pacabot/zhonx3-kicad/Zhonx_III_bt/gerber/Zhonx_III-F_Cu.dxf

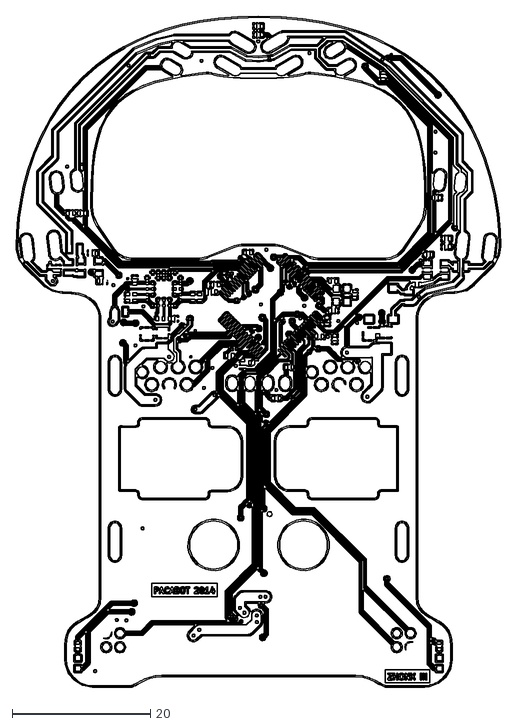
[picture p1: CAD file, 2015-01-23]
Zhonx_III_bt/gerber/Zhonx_III-F_Cu.dxf
70.0 x 97.0
