pacabot/zhonx3-kicad/Zhonx_III_mere_V3/Gerber/Zhonx_III-Edge_Cuts.dxf

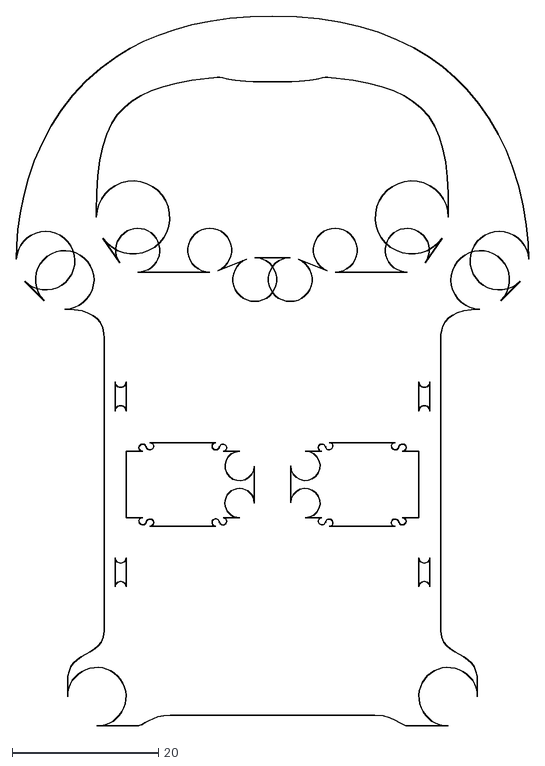
[picture p2: CAD file, 2015-01-23]
Zhonx_III_mere_V3/Gerber/Zhonx_III-Edge_Cuts.dxf
70.0 x 97.0
