pacabot/zhonx3-kicad/Zhonx_III_bt/gerber/ContourPCBrepris.dxf

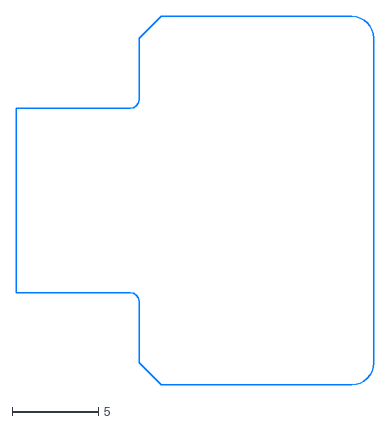
[picture p3: CAD file, 2015-01-23]
Zhonx_III_bt/gerber/ContourPCBrepris.dxf
20.7 x 21.3
