pacabot/zhonx3-kicad/Zhonx_III_bt/gerber/Zhonx_III-Edge_Cuts.dxf

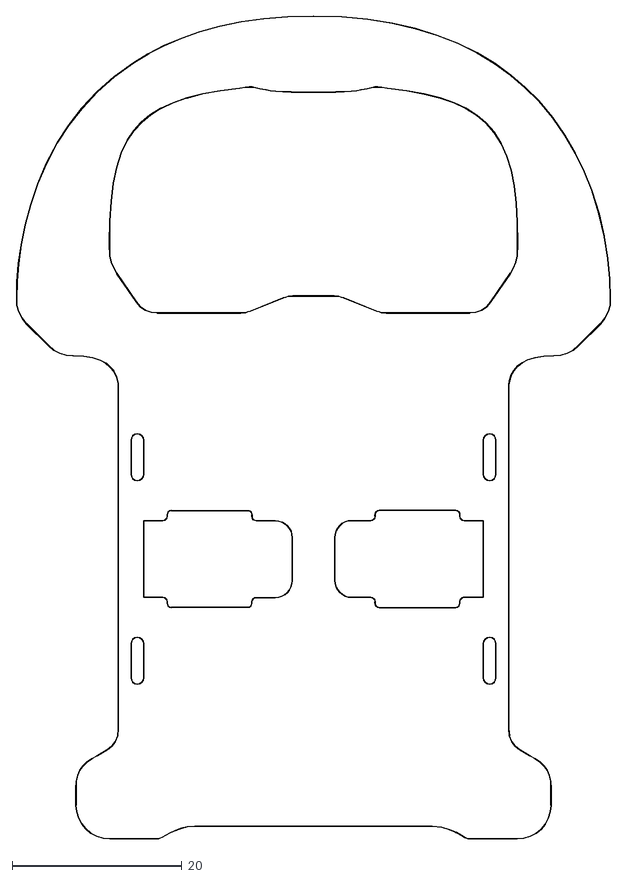
[picture p4: CAD file, 2015-01-23]
Zhonx_III_bt/gerber/Zhonx_III-Edge_Cuts.dxf
70.1 x 97.0
