pacabot/zhonx3-kicad/Zhonx_III_bt/gerber/Zhonx_III-B_Cu.dxf

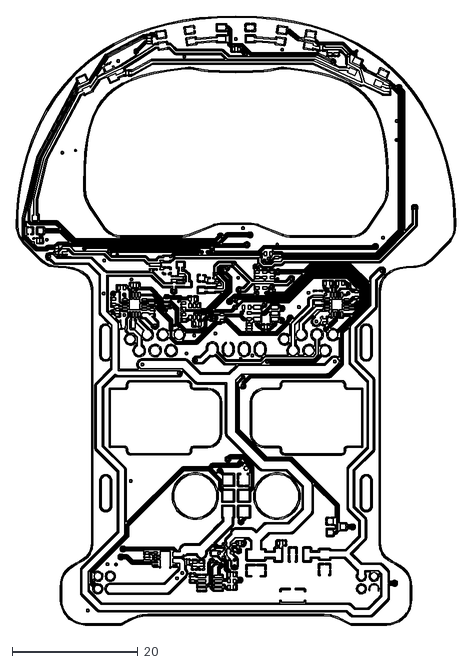
[picture p5: CAD file, 2015-01-23]
Zhonx_III_bt/gerber/Zhonx_III-B_Cu.dxf
70.0 x 97.0
