pacabot/zhonx3-kicad/Zhonx_III_bt/gerber/Zhonx3_carteBT-Edge_CutsV0.dxf

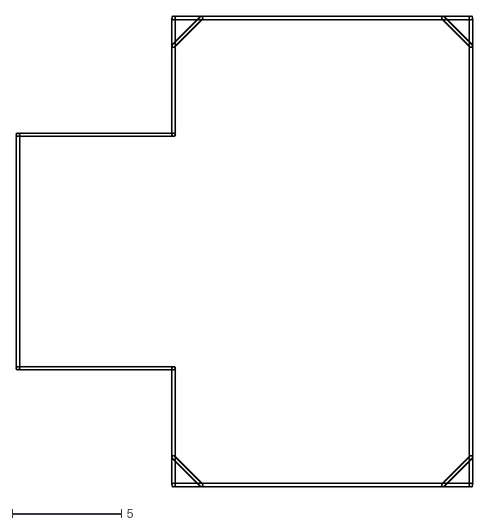
[picture p6: CAD file, 2015-01-23]
Zhonx_III_bt/gerber/Zhonx3_carteBT-Edge_CutsV0.dxf
20.9 x 21.5
