pacabot/zhonx3-kicad/Zhonx_III_bt/gerber/ContourPCBreprisV2.dxf

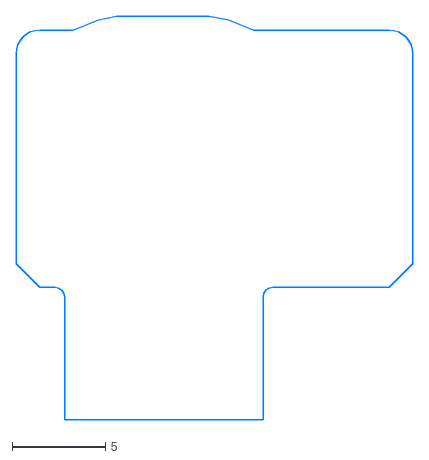
[picture p7: CAD file, 2015-01-23]
Zhonx_III_bt/gerber/ContourPCBreprisV2.dxf
21.3 x 21.7
