pacabot/zhonx3-kicad/Zhonx_III_base_V2/Gerber/Zhonx_III_Base-Edge_Cuts.dxf

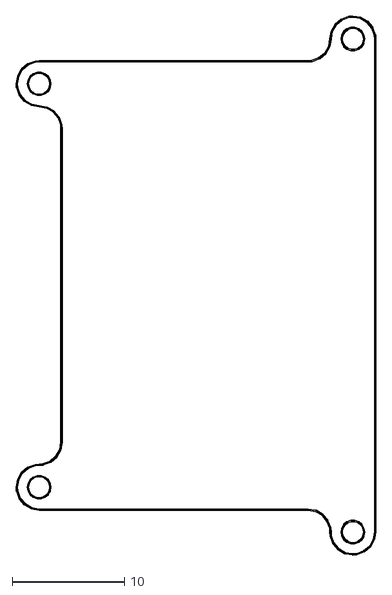
[picture p8: CAD file, 2015-05-01, an earlier design]
Zhonx_III_base_V2/Gerber/Zhonx_III_Base-Edge_Cuts.dxf
32.1 x 48.1
