pacabot/zhonx3-kicad/Zhonx_III_base_V2/Gerber/Zhonx_III_Base-F_Cu.dxf

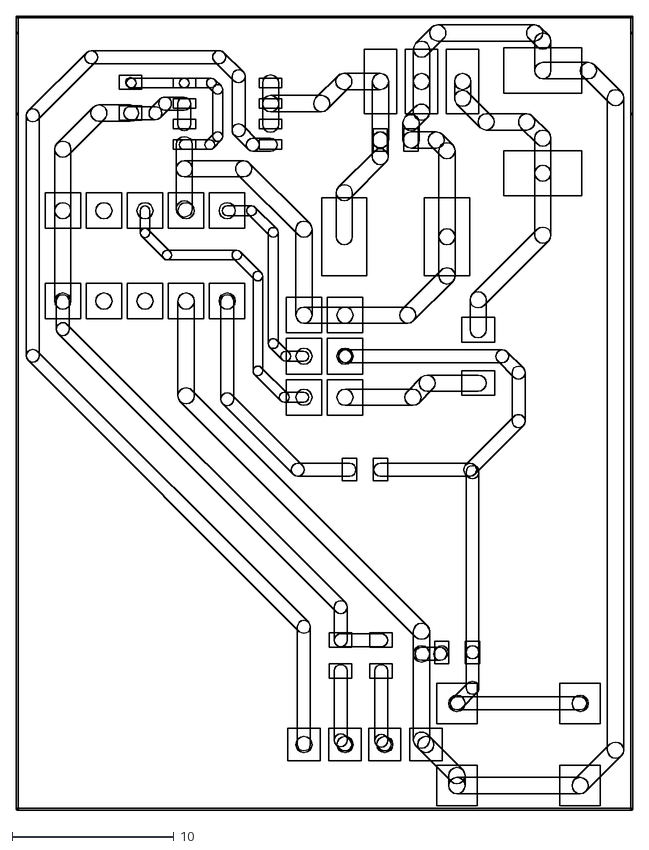
[picture p9: CAD file, 2015-01-23, an earlier design]
Zhonx_III_base_V2/Gerber/Zhonx_III_Base-F_Cu.dxf
38.1 x 49.1
