pacabot/zhonx3-kicad/(list of files, cad)

Other CAD files:
Zhonx_III_base_V2/CamBam/Zhonx_III_Base-Edge_Cuts_decompose.dxf
Zhonx_III_base_V2/CamBam/Zhonx_III_Base-Edge_Cuts.dxf
Zhonx_III_bt/gerber/Zhonx_III-F_SilkS.dxf
Zhonx_III_mere_V3/Gerber/Zhonx_III-B_Mask.dxf
Zhonx_III_mere_V3/Gerber/Zhonx_III-F_Mask.dxf
