pacabot/zhonx3-kicad/Zhonx_III_mere_V3/Zhonx_III.pdf

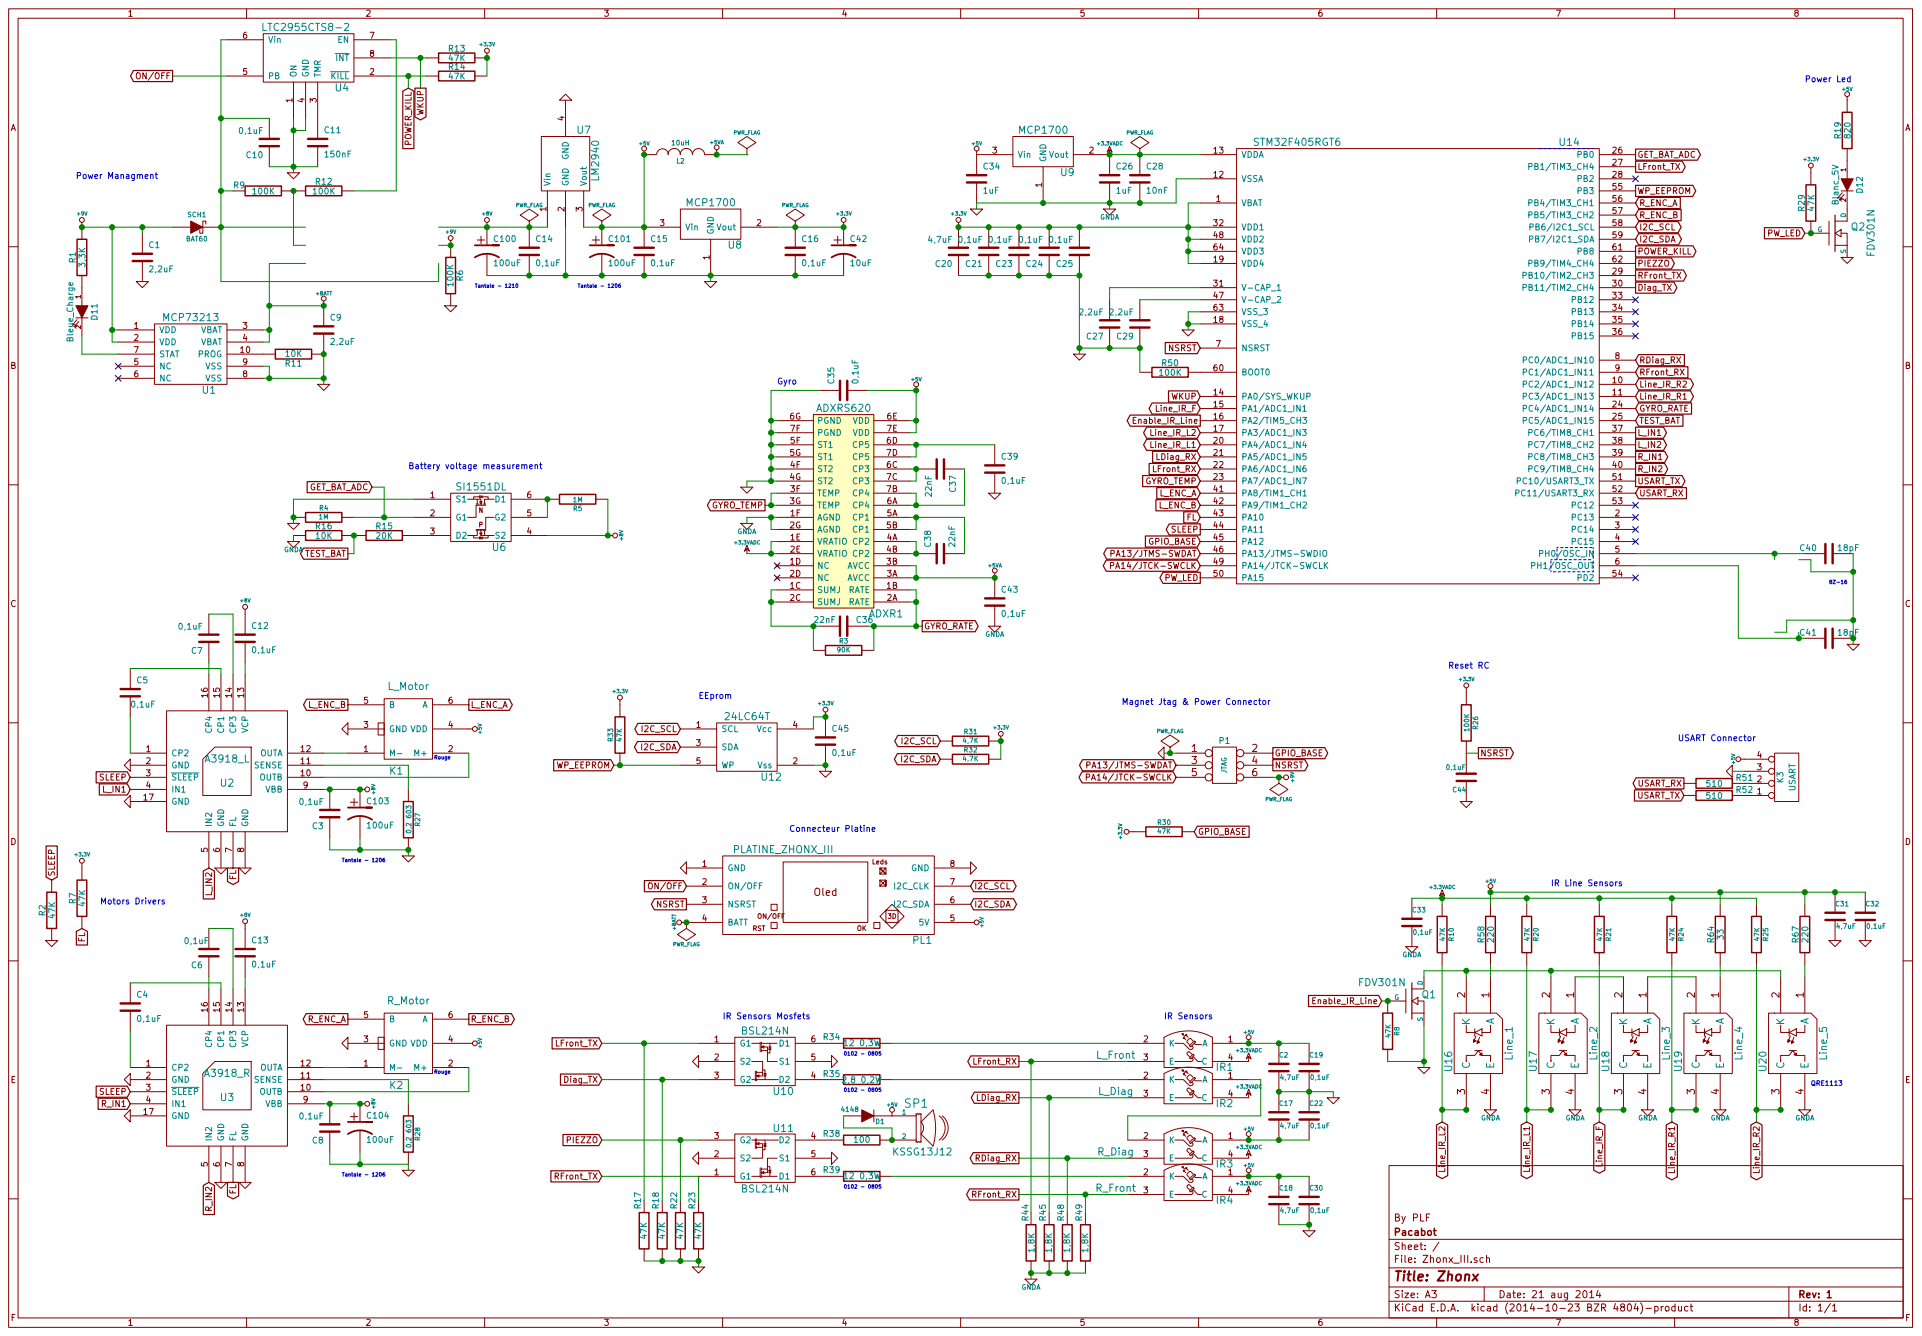
[picture p11: page 1]

PA13/JTMS-SWDAT PA14/JTCK-SWCLK

8 VBB 9 OUTB 10 SENSE 11 OUTA 12 VCP 13 CP3 14 CP1 15 CP4 16 GND 17 U2 A3918_L R27 0,2 603

8 VBB 9 OUTB 10 SENSE 11 OUTA 12 VCP 13 CP3 14 CP1 15 CP4 16 GND 17 U3 A3918_R R_IN2FL
