pacabot/zhonx3-kicad/Zhonx_III_bt/gerber/Zhonx3_carteBT.pdf

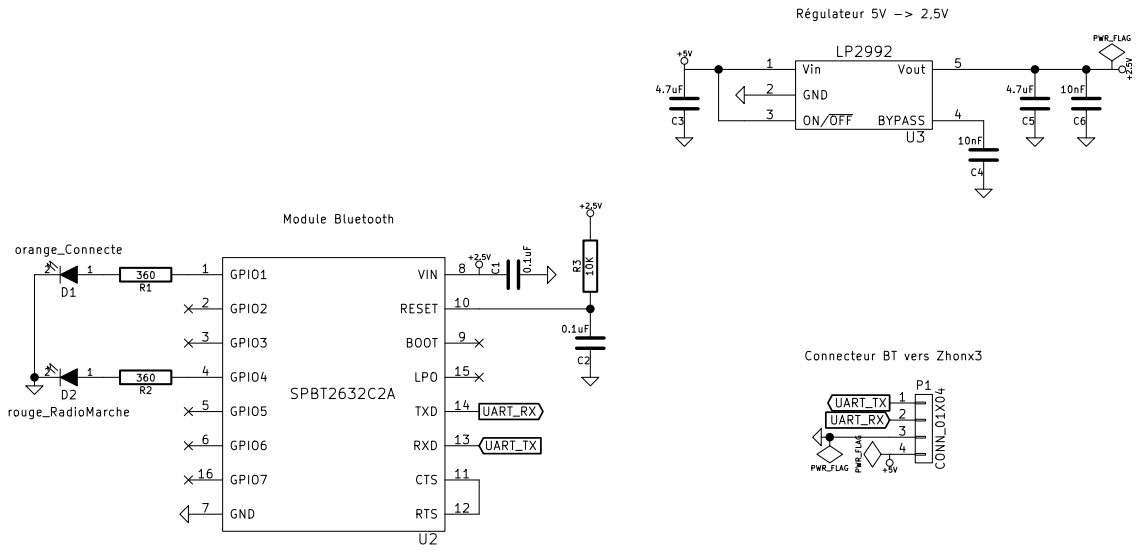
[picture p12: page 1]

10nF Connecteur BT vers Zhonx3 Régulateur 5V -> 2,5V Module Bluetooth
