pacabot/zhonx3-kicad/Zhonx_III_bt/gerber/Zhonx3_carteBT-B_Cu.pdf

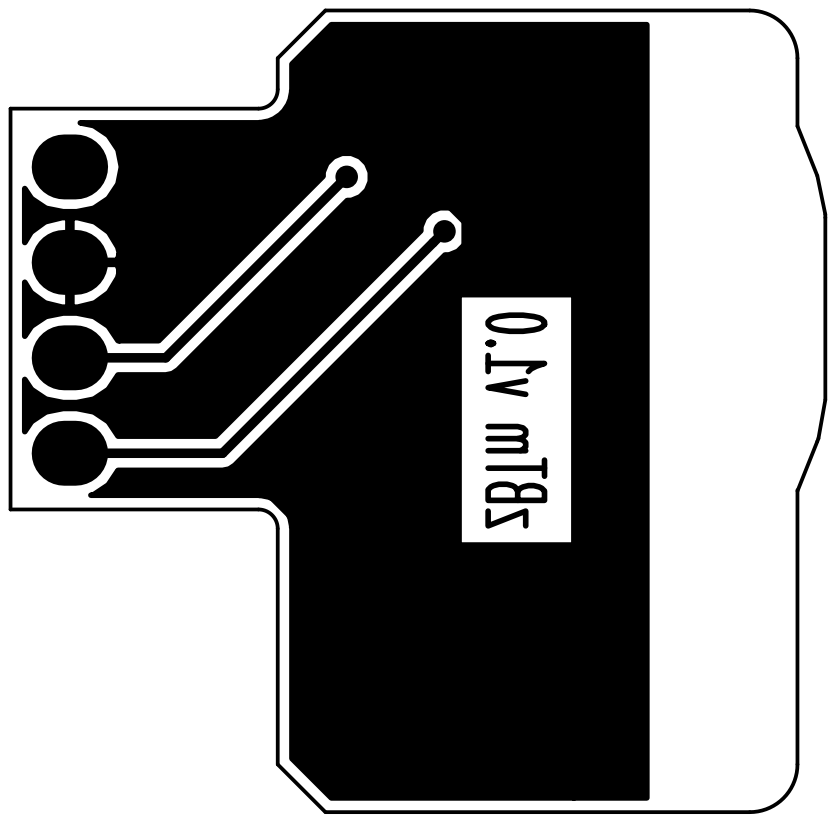
[picture p13: page 1]
