pacabot/zhonx3-kicad/Zhonx_III_bt/gerber/Zhonx3_carteBT-Edge_Cuts.pdf

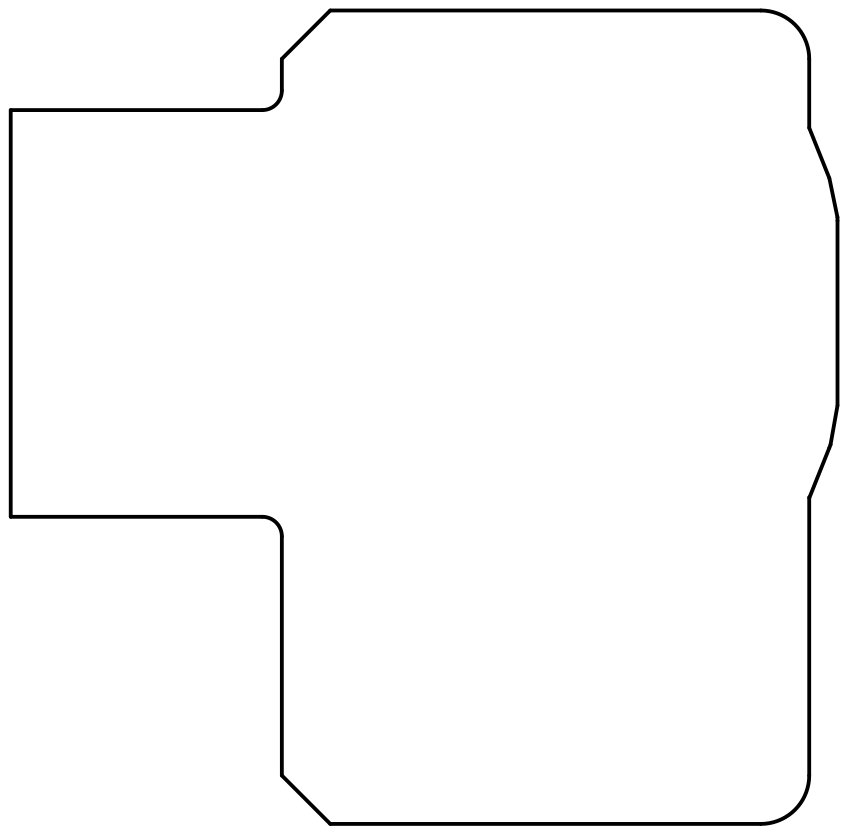
[picture p14: page 1]
