pacabot/zhonx3-kicad/Zhonx_III_bt/gerber/Zhonx3_carteBT-F_Cu.pdf

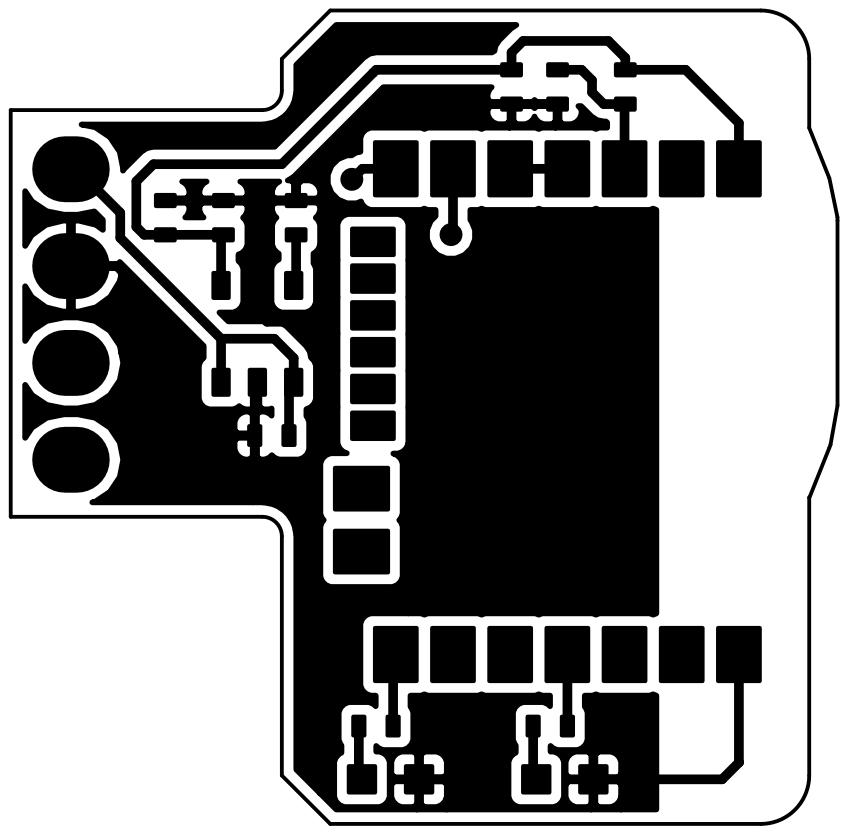
[picture p15: page 1]
