pacabot/zhonx3-kicad/Zhonx_III_bt/gerber/Zhonx3_carteBT-F_SilkS.pdf

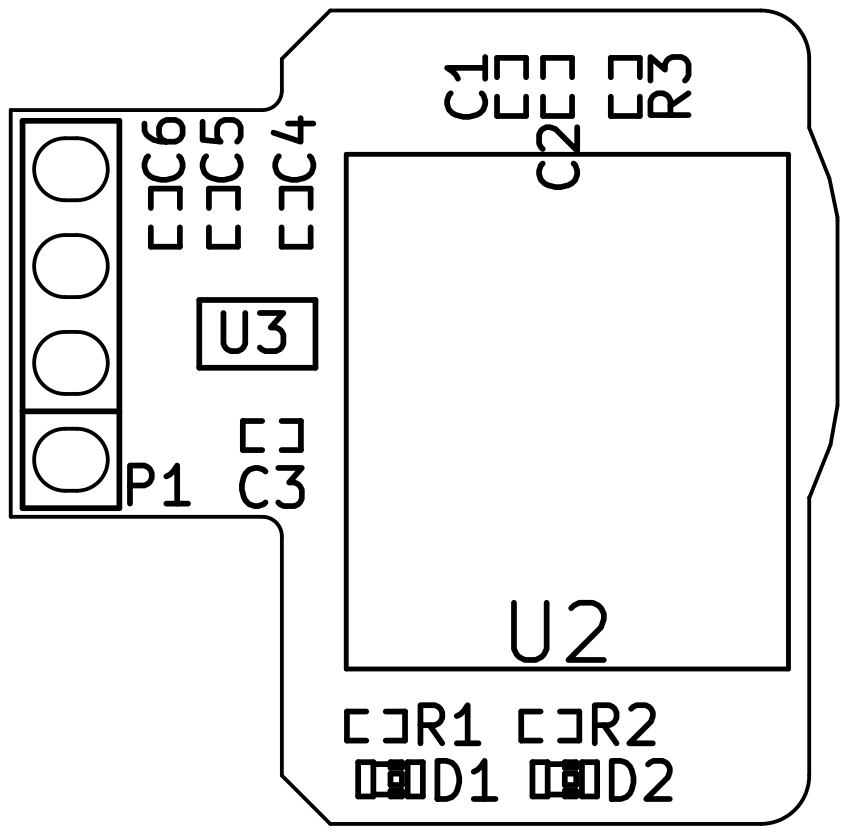
[picture p16: page 1]
