pacabot/zhonx3-kicad/Zhonx_III_mere_V3/Zhonx_III.cir

* EESchema Netlist Version 1.1 (Spice format) creation date: 07/05/2013 12:43:24

* To exclude a component from the Spice Netlist add [Spice_Netlist_Enabled] user FIELD set to: N
* To reorder the component spice node sequence add [Spice_Node_Sequence] user FIELD and define sequence: 2,1,0

*Sheet Name:/
R17  31 0 10K		
R18  30 0 10K		
R20  32 0 10K		
R21  29 0 10K		
R22  33 0 10K		
R23  28 0 10K		
U11  33 79 28 121 79 120 BSL214N		
U10  32 79 29 125 79 124 BSL214N		
R39  94 121 12 0,3W		
R34  25 122 12 0,3W		
U9  31 79 30 123 79 122 BSL214N		
SCH2  17 105 DIODESCH		
R14  141 67 10K		
C10  0 46 0,1uF		
R9  46 45 100K		
C11  119 0 150nF		
U4  0 141 119 0 65 46 27 153 LTC2955TS8-2		
R13  153 67 10K		
R12  45 27 100K		
SCH1  105 46 DIODESCH		
U5  45 64 105 46 46 55 IRF5810		
R35  123 24 5,6 0,2W		
R38  43 120 5,6 0,2W		
R37  125 43 5,6 0,2W		
R36  124 24 5,6 0,2W		
R49  26 0 1,8K		
R48  23 0 1,8K		
R1  130 105 ?		
D11  130 10 Bleue_Charge		
C30  93 0 4,7uF		
D9  127 35 Orange		
R32  127 93 820		
D8  36 126 Orange		
R31  36 93 820		
R24  111 93 820		
R25  5 93 820		
R26  112 93 820		
R27  38 93 820		
R28  129 93 820		
R29  4 93 820		
R58  128 93 82		
U6  39 138 3 103 40 0 110 34 126 35 81 104 96 67 78 106 0 MAX7317		
R6  0 105 100K		
C1  105 0 2,2uF		
C9  64 11 2,2uF		
R11  11 47 10K		
P1  20 18 48 77 19 17 51 11 JTAG		
U2  159 0 117 150 100 21 11 55 57 56 22 0 118 12 113 144 0 A3950_L		
C12  22 56 0,1uF		
R2  0 117 5K		
U1  105 105 64 64 101 99 10 11 11 47 MCP73213		
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
F1  64 75 FUSE		
C38  77 0 0,1uF		
R66  67 77 100K		
R62  61 95 12		
L1  67 108 10uH		
U15  66 79 60 62 79 61 BSL214N		
R57  66 0 10K		
R59  60 0 10K		
C2  0 65 0,1uF		
BT1  75 11 LYPO_2S		
D10  80 81 Vert		
R68  80 93 820		
U8  0 67 93 MCP1703		

.end
