pacabot/zhonx3-kicad/(list of files, drawings)

Other design files:
Zhonx_III_base_V2/Zhonx_III_Base.dsn
Zhonx_III_bt/Zhonx3_carteBT.dsn
Zhonx_III_mere_V3/Freerouter/Zhonx_III.dsn
Zhonx_III_mere_V3/Zhonx_III.dsn
Zhonx_III_platine/Zhonx_Platine.dsn
