pacabot/zhonx3-kicad/Zhonx_III_base_V2/Zhonx_III_Base.kicad_pcb

## KiCad design Zhonx_III_base_V2/Zhonx_III_Base.kicad_pcb (2015-05-01, an earlier design)

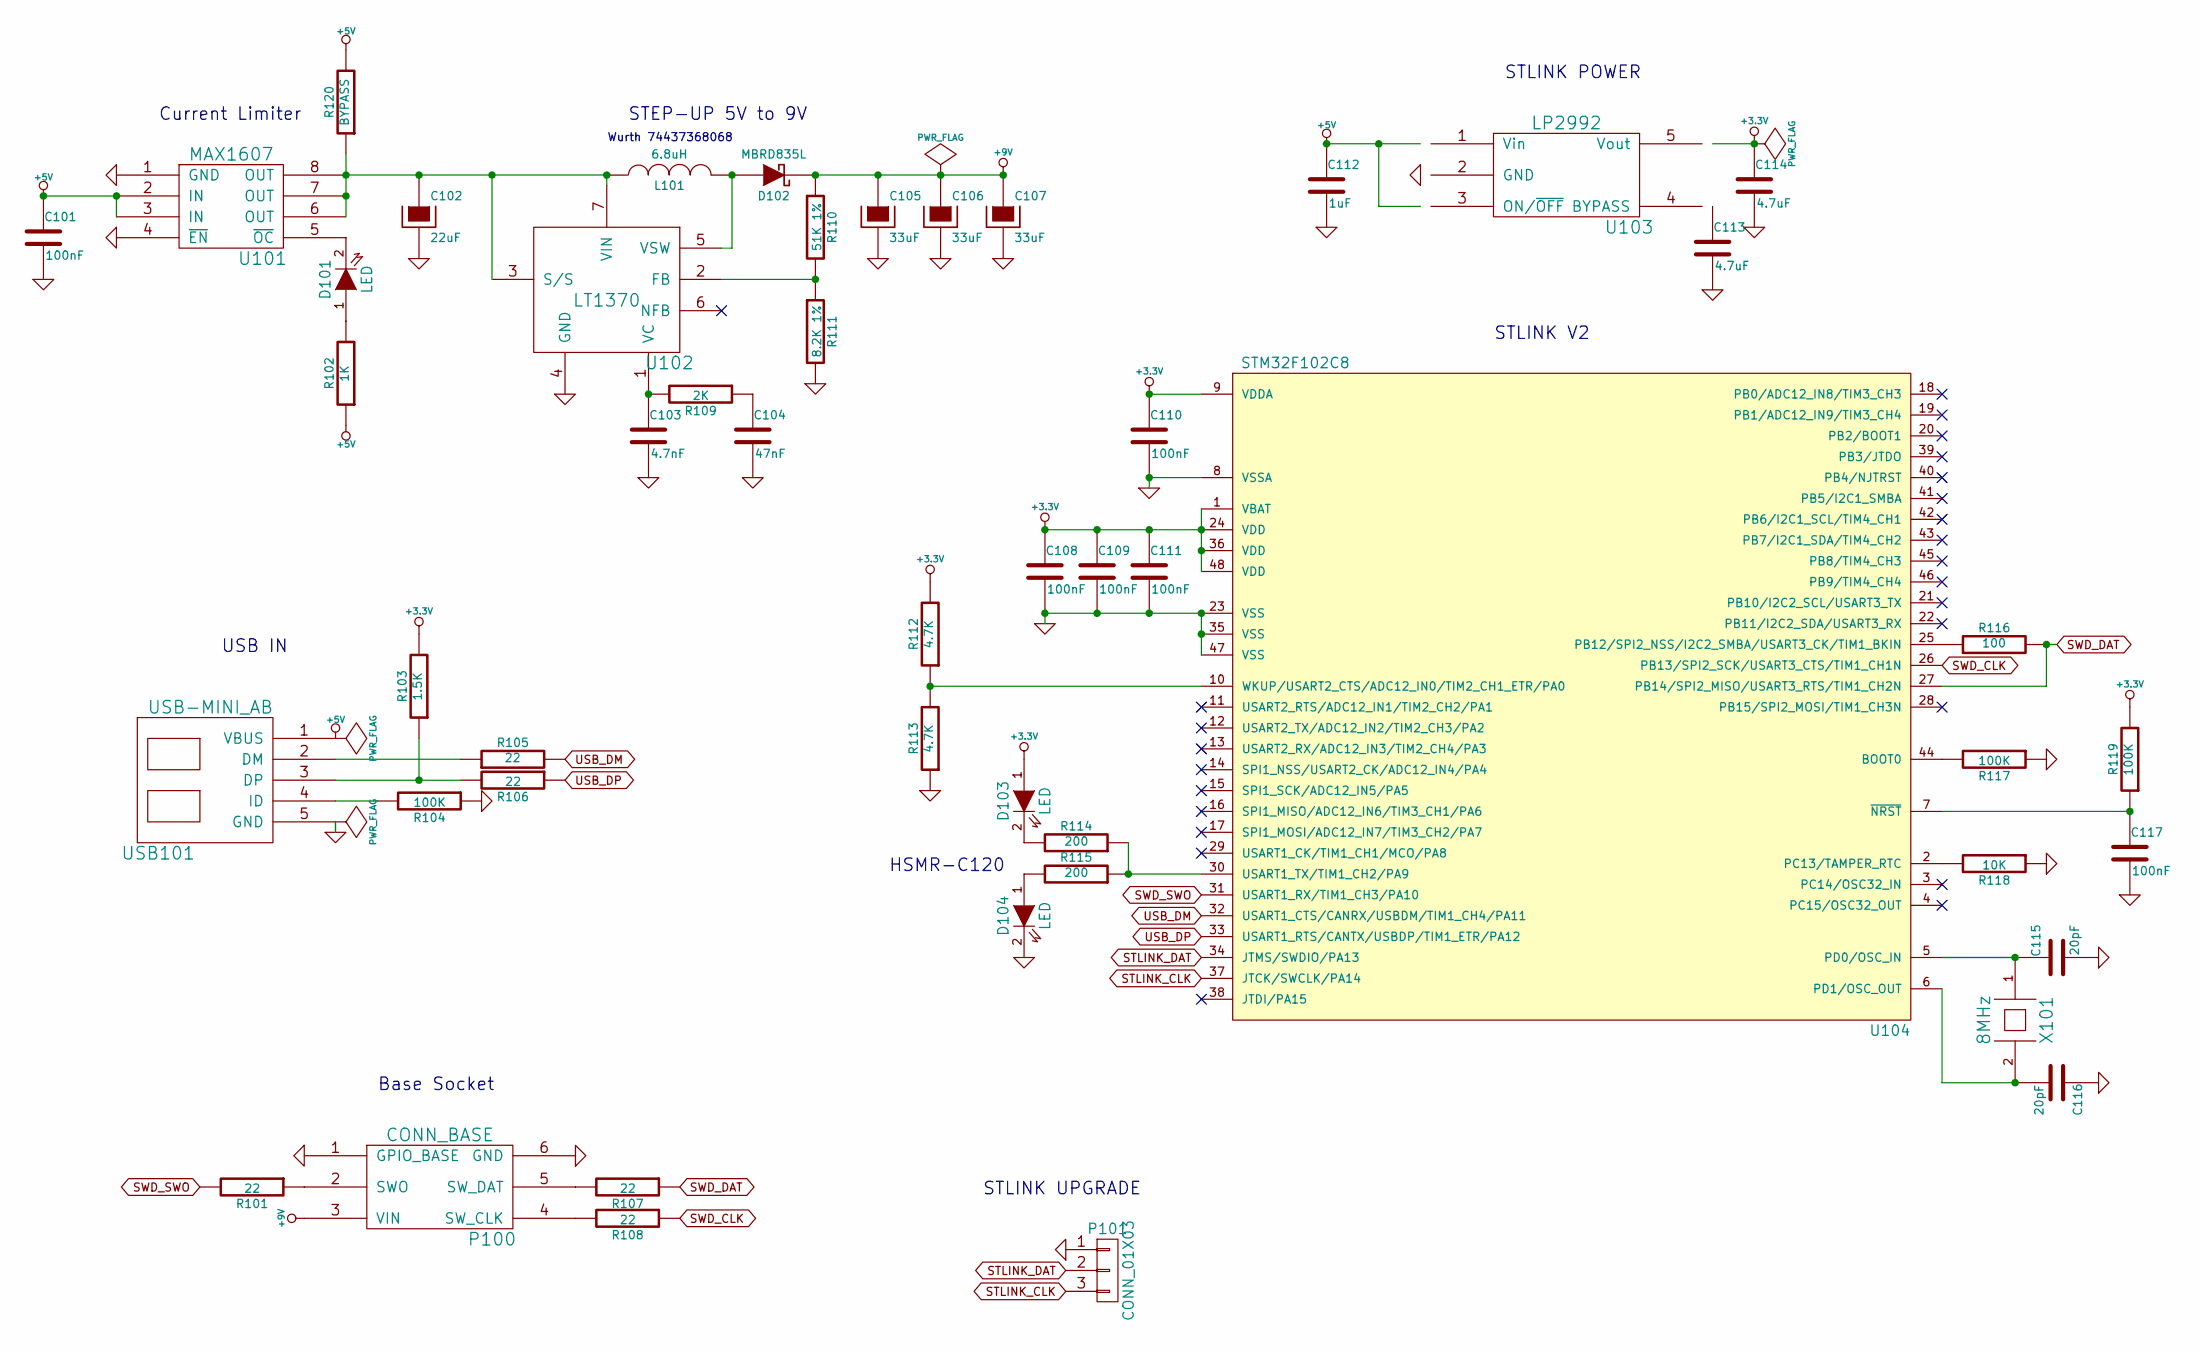
[picture p21: schematic Zhonx_III_Base.sch]

Parts:
C101, C108, C109, C110, C111, C117: 100nF; C_0603
C102: 22uF; C_1812
C103: 4.7nF; C_0603
C104: 47nF; C_0603
C105, C106, C107: 33uF; C_1812
C112: 1uF; C_0603
C113, C114: 4.7uF; C_0805
C115, C116: 20pF; C_0603
D101, D103, D104: LED; LED_HMSx-C120
D102: MBRD835L; DPAK_2
L101: 6.8uH; WURTH_INDUCTOR_1040
P100: CONN_BASE
P101: CONN_01X03; GS3
R101, R105, R106, R107, R108: 22; R_0603
R102: 1K; R_0603
R103: 1.5K; R_0603
R104, R117, R119: 100K; R_0603
R109: 2K; R_0603
R110: 51K 1%; R_0603
R111: 8.2K 1%; R_0603
R112, R113: 4.7K; R_0603
R114, R115: 200; R_0603
R116: 100; R_0603
R118: 10K; R_0603
R120: BYPASS; GS2
U101: MAX1607; SO-8
U102: LT1370; DD_PAK_7
U103: LP2992; SOT23-5
U104: STM32F102C8; LQFP-48_7x7mm_Pitch0.5mm
USB101: USB-MINI_AB; USB_MINI_AB
X101: 8MHz; Q_5x3.2

Connections:
+3.3V: C108.1, C109.1, C110.1, C111.1, C114.1, D103.1 (A), R103.2, R112.2, R119.2, U103.5 (Vout), U104.1 (VBAT), U104.9 (VDDA), U104.24 (VDD), U104.36 (VDD), U104.48 (VDD)
+5V: C101.1, C112.1, R102.1, R120.2, U101.2 (IN), U101.3 (IN), U103.1 (Vin), U103.3 (ON/~OFF), USB101.1 (VBUS)
+9V: C105.1, C106.1, C107.1, D102.2 (K), P100.3 (VIN), R110.1
GND: C101.2, C102.2, C103.2, C104.2, C105.2, C106.2, C107.2, C108.2, C109.2, C110.2, C111.2, C112.2, C113.2, C114.2, C115.2, C116.1, C117.2, D104.2 (K), P100.1 (GPIO_BASE), P100.6 (GND), P101.1, R104.1, R111.2, R113.1, R117.1, R118.1, U101.1 (GND), U101.4 (~EN), U102.4 (GND), U103.2 (GND), U104.8 (VSSA), U104.23 (VSS), U104.35 (VSS), U104.47 (VSS), USB101.5 (GND)
unnamed: C102.1, L101.1, R120.1, U101.6 (OUT), U101.7 (OUT), U101.8 (OUT), U102.3 (S/S), U102.7 (VIN)
unnamed: C103.1, R109.2, U102.1 (VC)
unnamed: C104.1, R109.1
unnamed: C113.1, U103.4 (BYPASS)
unnamed: C115.1, U104.5 (PD0/OSC_IN), X101.1
unnamed: C116.2, U104.6 (PD1/OSC_OUT), X101.2
unnamed: C117.1, R119.1, U104.7 (~NRST)
unnamed: D101.1 (A), R102.2
unnamed: D101.2 (K), U101.5 (~OC)
unnamed: D102.1 (A), L101.2, U102.5 (VSW)
unnamed: D103.2 (K), R114.2
unnamed: D104.1 (A), R115.2
unnamed: P100.2 (SWO), R101.1
unnamed: P100.4 (SW_CLK), R108.2
unnamed: P100.5 (SW_DAT), R107.2
unnamed: R103.1, R106.2, USB101.3 (DP)
unnamed: R104.2, USB101.4 (ID)
unnamed: R105.1, USB101.2 (DM)
unnamed: R110.2, R111.1, U102.2 (FB)
unnamed: R112.1, R113.2, U104.10 (WKUP/USART2_CTS/ADC12_IN0/TIM2_CH1_ETR/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)
unnamed: R114.1, R115.1, U104.30 (USART1_TX/TIM1_CH2/PA9)
unnamed: R116.1, U104.25 (PB12/SPI2_NSS/I2C2_SMBA/USART3_CK/TIM1_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)
unnamed: R117.2, U104.44 (BOOT0)
unnamed: R118.2, U104.2 (PC13/TAMPER_RTC)
STLINK_CLK: P101.3, U104.37 (JTCK/SWCLK/PA14)
STLINK_DAT: P101.2, U104.34 (JTMS/SWDIO/PA13)
SWD_CLK: R108.1, U104.26 (PB13/SPI2_SCK/USART3_CTS/TIM1_CH1N)
SWD_DAT: R107.1, R116.2, U104.27 (PB14/SPI2_MISO/USART3_RTS/TIM1_CH2N)
SWD_SWO: R101.2, U104.31 (USART1_RX/TIM1_CH3/PA10)
USB_DM: R105.2, U104.32 (USART1_CTS/CANRX/USBDM/TIM1_CH4/PA11)
USB_DP: R106.1, U104.33 (USART1_RTS/CANTX/USBDP/TIM1_ETR/PA12)

Notes on the sheet:
STLINK UPGRADE
Base Socket
STEP-UP 5V to 9V
Current Limiter
USB IN
STLINK V2
STLINK POWER
Wurth 74437368068
HSMR-C120

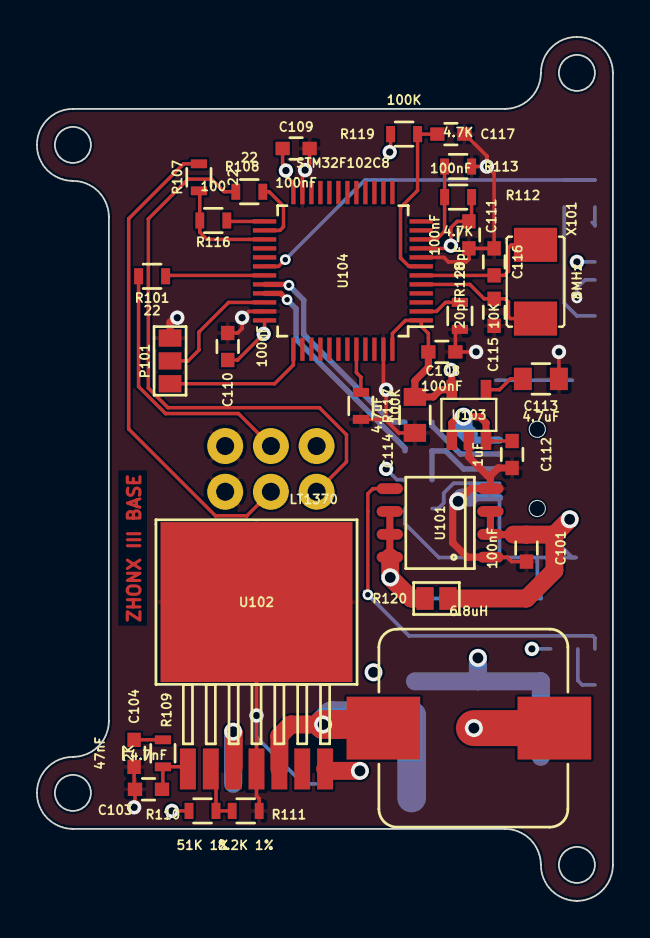
[picture p22: board Zhonx_III_base_V2/Zhonx_III_Base.kicad_pcb from above]

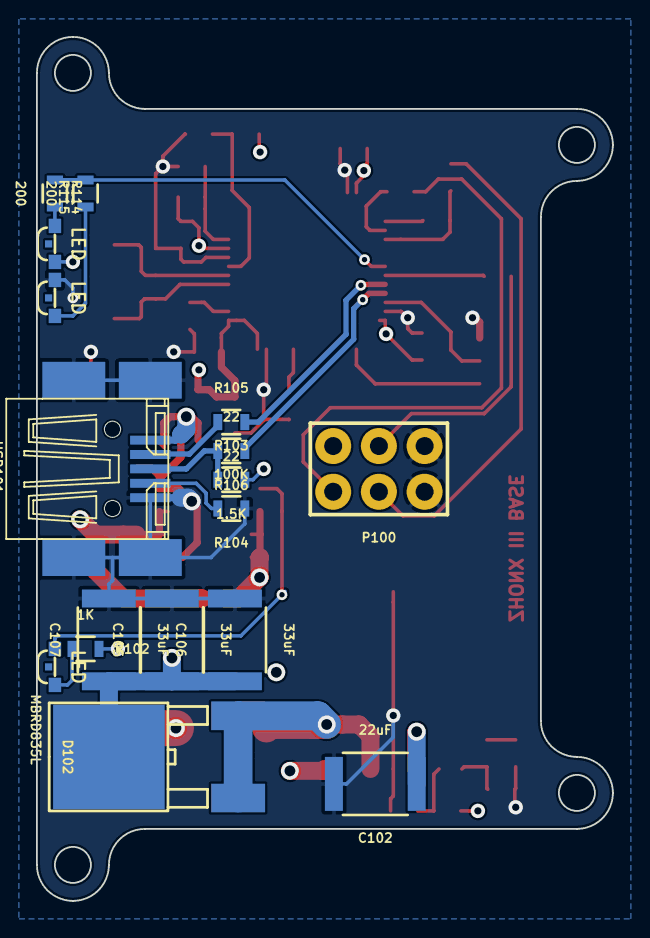
[picture p23: board Zhonx_III_base_V2/Zhonx_III_Base.kicad_pcb from below]

Board: 4 copper layers, 32.0 x 48.0 mm, 50 parts (17 on the bottom side), 35 nets.
