pacabot/zhonx3-kicad/Zhonx_III_bt/Zhonx3_carteBT.kicad_pcb

## KiCad design Zhonx_III_bt/Zhonx3_carteBT.kicad_pcb (2015-03-05)

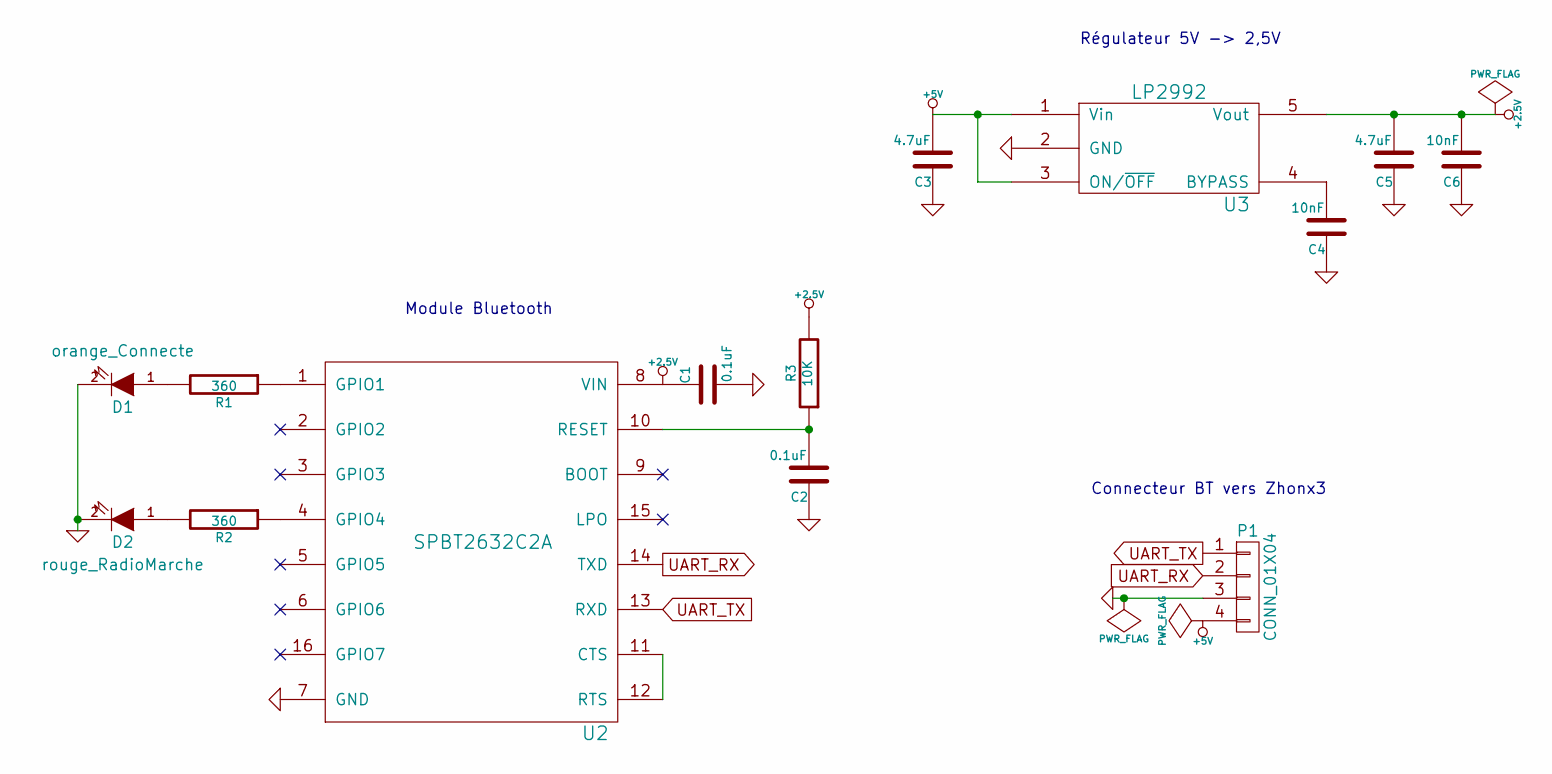
[picture p24: schematic Zhonx3_carteBT.sch]

Parts:
C1, C2: 0.1uF; SMD-0402_c
C3, C5: 4.7uF; SMD-0402_c
C4, C6: 10nF; SMD-0402_c
D1: orange_Connecte; LED-0603
D2: rouge_RadioMarche; LED-0603
P1: CONN_01X04; Socket_Strip_Straight_1x04
R1, R2: 360; SMD-0402_r
R3: 10K; SMD-0402_r
U2: SPBT2632C2A
U3: LP2992; SOT-23-5

Connections:
+2.5V: C1.1, C5.2, C6.2, R3.2, U2.8 (VIN), U3.5 (Vout)
+5V: C3.2, P1.4, U3.1 (Vin), U3.3 (ON/~OFF)
GND: C1.2, C2.1, C3.1, C4.1, C5.1, C6.1, D1.2 (K), D2.2 (K), P1.3, U2.7 (GND), U3.2 (GND)
unnamed: C2.2, R3.1, U2.10 (RESET)
unnamed: C4.2, U3.4 (BYPASS)
unnamed: D1.1 (A), R1.2
unnamed: D2.1 (A), R2.2
unnamed: R1.1, U2.1 (GPIO1)
unnamed: R2.1, U2.4 (GPIO4)
unnamed: U2.11 (CTS), U2.12 (RTS)
UART_RX: P1.2, U2.14 (TXD)
UART_TX: P1.1, U2.13 (RXD)

Notes on the sheet:
Connecteur BT vers Zhonx3
Régulateur 5V -> 2,5V
Module Bluetooth

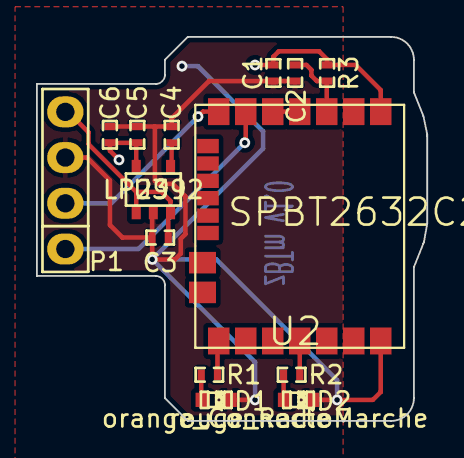
[picture p25: board Zhonx3_carteBT.kicad_pcb from above]

Board: 4 copper layers, 21.7 x 21.3 mm, 14 parts (0 on the bottom side), 12 nets.
