pacabot/zhonx3-kicad/Zhonx_III_base/Zhonx_III_Base.kicad_pcb

## KiCad design Zhonx_III_base/Zhonx_III_Base.kicad_pcb (2015-01-23)

Schematic: Zhonx_III_Base.sch

Parts:
C1, C2, C5: 100nF
D1, D2: LED
JT1: JTAG_ZHONX
P1: CONN_BASE
R1: R
R2, R3: 1K
R4: 0
SW1: SW_PUSH
U1: MAX1607
U2: POLOLU_U3V50

Connections:
+5V: C1.1, JT1.5, JT1.6, R2.1, R3.1, U1.2 (IN), U1.3 (IN)
+9V: P1.3 (VIN), R4.2
/RST: C5.2, P1.2 (RST), R1.1, SW1.1
/SWD_CLK: JT1.8, P1.4 (SW_CLK)
/SWD_DAT: JT1.10, P1.5 (SW_DAT)
GND: C1.2, C2.2, C5.1, D1.2 (K), JT1.2, JT1.9, P1.1 (GPIO_BASE), P1.6 (GND), SW1.2, U1.1 (GND), U1.4 (~EN), U2.1 (GND), U2.3 (GND)
unnamed: D2.1 (A), R3.2
unnamed: R4.1, U2.4 (VOUT)
unnamed: D2.2 (K), U1.5 (~OC)
unnamed: D1.1 (A), R2.2
unnamed: JT1.1, R1.2
unnamed: C2.1, U1.6 (OUT), U1.7 (OUT), U1.8 (OUT), U2.2 (VIN)

Notes on the sheet:
JTAG STM32
Base Socket
STEP-UP 5V to 9V
Current Limiter

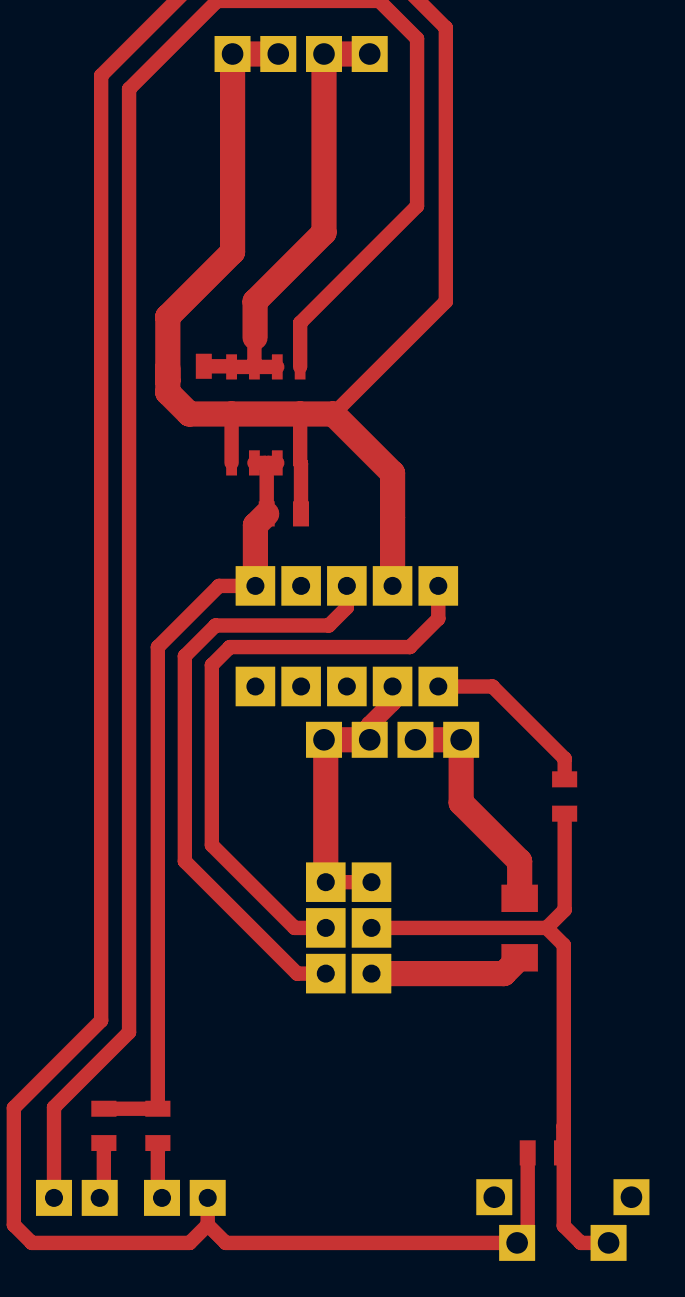
[picture p29: board Zhonx_III_base/Zhonx_III_Base.kicad_pcb from above]

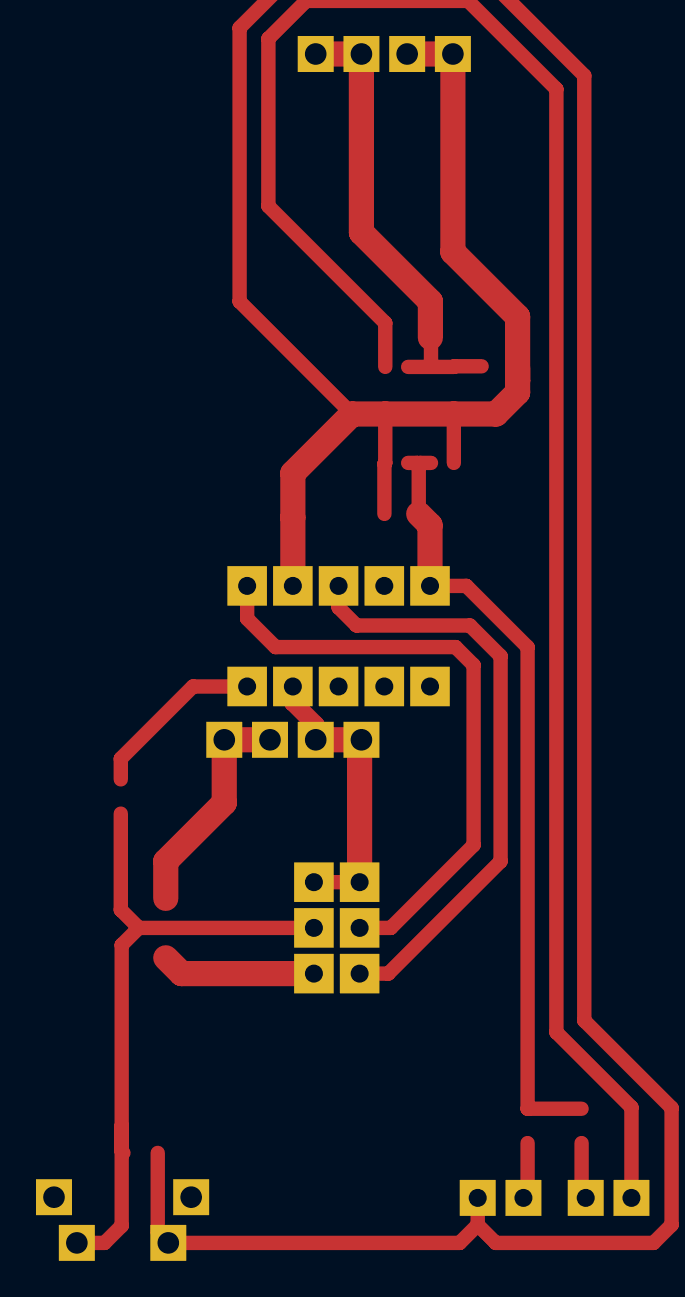
[picture p30: board Zhonx_III_base/Zhonx_III_Base.kicad_pcb from below]

Board: 2 copper layers, 14 parts (6 on the bottom side), 12 nets.
