pacabot/zhonx3-kicad/Zhonx_III_base/Zhonx_III_Base.sch

## KiCad design Zhonx_III_base/Zhonx_III_Base.sch (2015-01-23)

Schematic: Zhonx_III_Base.sch

Parts:
C1, C2, C5: 100nF
D1, D2: LED
JT1: JTAG_ZHONX
P1: CONN_BASE
R1: R
R2, R3: 1K
R4: 0
SW1: SW_PUSH
U1: MAX1607
U2: POLOLU_U3V50

Notes on the sheet:
JTAG STM32
Base Socket
STEP-UP 5V to 9V
Current Limiter
