pacabot/zhonx3-kicad/Zhonx_III_mere_V3/Zhonx_III.sch

## KiCad design Zhonx_III_mere_V3/Zhonx_III.sch (2017-01-27)



Parts:
ADXR1: ADXRS620
C1, C9, C27, C29: 2,2uF; SM0402_ZHONX
C2, C17, C18, C20, C31: 4,7uF; SM0402_ZHONX
C3, C4, C5, C6, C7, C8, C10, C12, C13, C14, C15, C16, C19, C21, C22, C23, C24, C25, C30, C32, C33, C35, C39, C43, C44, C45: 0,1uF; SM0402_ZHONX
C11: 150nF; SM0402_ZHONX
C26, C34: 1uF; SM0402_ZHONX
C28: 10nF; SM0402_ZHONX
C36, C37, C38: 22nF; SM0402_ZHONX
C40, C41: 18pF; SM0402_ZHONX
C42: 10uF; SM0603_Capa
C100: 100uF; SM1210_Capa
C101, C103, C104: 100uF; SM1206_Capa
D1: 4148; SM0603
D11: Bleue_Charge; LED-0603
D12: Blanc_5V; LED-0603
IR1: L_Front; IR_LF
IR2: L_Diag; IR_LD
IR3: R_Diag; IR_RD
IR4: R_Front; IR_RF
K1: L_Motor; Connecteur_Moteur_Zhonx
K2: R_Motor; Connecteur_Moteur_Zhonx
K3: USART; Conn_Serial_Zhonx
L2: 10uH; SM0603
P1: JTAG; Zhonx_III_JTAG
PL1: PLATINE_ZHONX_III; Platine_Zhonx_III
Q1, Q2: FDV301N; SOT23GDS
R1: 3,3K; SM0402_ZHONX
R2, R7, R8, R10, R13, R14, R17, R18, R20, R21, R22, R23, R24, R25, R29, R30, R33: 47K; SM0402_ZHONX
R3: 90K; SM0402_ZHONX
R4, R5: 1M; SM0402_ZHONX
R6, R9, R12, R26, R50: 100K; SM0402_ZHONX
R11, R16: 10K; SM0402_ZHONX
R15: 20K; SM0402_ZHONX
R19: 820; SM0402_ZHONX
R27, R28: 0,2 603; SM0603_ZHONX
R31, R32: 4,7K; SM0402_ZHONX
R34, R39: 12 0,3W; SM0603_ZHONX
R35: 2,8 0,2W; SM0603_ZHONX
R38: 100; SM0402_ZHONX
R44, R45, R48, R49: 1,8K; SM0402_ZHONX
R51, R52: 510; SM0402_ZHONX
R58, R67: 220; SM0402_ZHONX
R64: 33; SM0402_ZHONX
SCH1: BAT60; SOD323
SP1: KSSG13J12; Buzzer_KSSG13J12
U1: MCP73213
U2: A3918_L; QFN16_Termal_Pad
U3: A3918_R; QFN16_Termal_Pad
U4: LTC2955CTS8-2; LTC2955
U5: SIB911DK; SC75-6L
U6: SI1551DL; SC70
U7: LM2940; SOT223
U8, U9: MCP1700; SOT23
U10, U11: BSL214N; SOT23_6
U12: 24LC64T; SOT23-5
U14: STM32F405RGT6; TQFP_64
U16: Line_1; QRE1113GR
U17: Line_2; QRE1113GR
U18: Line_3; QRE1113GR
U19: Line_4; QRE1113GR
U20: Line_5; QRE1113GR
X1: QUARTZ_8Z; Quartz_8Z-16MHz

Connections:
+3.3V: C16.1, C20.2, C21.2, C23.2, C24.2, C25.2, C42.1, C45.1, R7.1, R13.2, R14.2, R26.1, R29.2, R30.1, R31.2, R32.2, R33.2, U8.2 (Vout), U12.4 (Vcc), U14.1 (VBAT), U14.19 (VDD4), U14.32 (VDD1), U14.48 (VDD2), U14.64 (VDD3)
+3.3VADC: ADXR1.1E (VRATIO), ADXR1.2E (VRATIO), C26.1, C28.1, C33.1, IR1.4 (C), IR2.4 (C), IR3.4 (C), IR4.4 (C), R10.1, R20.1, R21.1, R24.1, R25.1, U9.2 (Vout), U14.13 (VDDA)
+5V: ADXR1.6E (VDD), ADXR1.7E (VDD), C2.1, C15.1, C17.2, C18.1, C19.1, C22.2, C30.1, C31.1, C32.1, C34.1, C35.2, C101.1, D1.2 (K), IR1.1 (A), IR3.1 (A), IR4.1 (A), K1.4 (VDD), K2.4 (VDD), K3.4, L2.1, PL1.5 (5V), R19.2, R58.2, R64.2, R67.2, SP1.1, U7.3 (Vout), U8.3 (Vin), U9.3 (Vin)
+5VA: ADXR1.3A (AVCC), ADXR1.3B (AVCC), C43.1, L2.2
+8V: C3.2, C8.2, C12.1, C13.1, C14.1, C100.1, C103.1, C104.1, R5.1, U2.9 (VBB), U3.9 (VBB), U5.6 (D1), U6.4 (S2), U7.1 (Vin)
+9V: C1.1, P1.6, R1.2, R6.1, SCH1.1 (A), U1.1 (VDD), U1.2 (VDD), U5.5 (G2)
+BATT: C9.1, PL1.4 (BATT), U1.3 (VBAT), U1.4 (VBAT), U5.3 (D2)
Diag_TX: R18.1, U10.3 (G2), U14.30 (PB11)
Enable_IR_Line: Q1.G, R8.1, U14.16 (PA2/ADC3_IN2)
FL: R7.2, U2.7 (FL), U3.7 (FL), U14.43 (PA10)
GET_BAT_ADC: R4.2, U6.2 (G1), U14.26 (PB0)
GND: ADXR1.1F (AGND), ADXR1.2G (AGND), ADXR1.4F (ST2), ADXR1.4G (ST2), ADXR1.5F (ST1), ADXR1.5G (ST1), ADXR1.6G (PGND), ADXR1.7F (PGND), C1.2, C2.2, C3.1, C8.1, C9.2, C10.1, C11.2, C14.2, C15.2, C16.2, C17.1, C18.2, C19.2, C20.1, C21.1, C22.1, C23.1, C24.1, C25.1, C26.2, C27.1, C28.2, C29.1, C30.2, C31.2, C32.2, C33.2, C34.2, C35.1, C39.2, C40.2, C41.2, C42.2, C43.2, C44.1, C45.2, C100.2, C101.2, C103.2, C104.2, K1.3 (GND), K2.3 (GND), K3.3, P1.1, PL1.1 (GND), PL1.8 (GND), Q1.S, Q2.S, R2.1, R4.1, R6.2, R8.2, R11.1, R16.1, R17.2, R18.2, R22.2, R23.2, R27.2, R28.2, R44.1, R45.2, R48.2, R49.2, R50.1, U1.8 (VSS), U1.9 (VSS), U2.2 (GND), U2.6 (GND), U2.8 (GND), U2.17 (GND), U3.2 (GND), U3.6 (GND), U3.8 (GND), U3.17 (GND), U4.1 (ON), U4.4 (GND), U6.1 (S1), U7.2 (GND), U7.4 (GND), U8.1 (GND), U9.1 (GND), U10.2 (S2), U10.5 (S1), U11.2 (S2), U11.5 (S1), U12.2 (Vss), U14.12 (VSSA), U14.18 (VSS_4), U14.63 (VSS_3), U16.4 (E), U17.4 (E), U18.4 (E), U19.4 (E), U20.4 (E), X1.2 (GND), X1.4 (GND)
GPIO_BASE: P1.2, R30.2, U14.45 (PA12)
GYRO_RATE: ADXR1.1B (RATE), ADXR1.2A (RATE), C36.1, R3.2, U14.24 (PC4/ADC1_IN14)
GYRO_TEMP: ADXR1.3F (TEMP), ADXR1.3G (TEMP), U14.23 (PA7/ADC1_IN7)
I2C_SCL: PL1.7 (I2C_CLK), R31.1, U12.1 (SCL), U14.58 (PB6/I2C1_SCL)
I2C_SDA: PL1.6 (I2C_SDA), R32.1, U12.3 (SDA), U14.59 (PB7/I2C1_SDA)
LDiag_RX: IR2.3 (E), R45.1, U14.21 (PA5/ADC2_IN5)
LFront_RX: IR1.3 (E), R44.2, U14.22 (PA6/ADC2_IN6)
LFront_TX: R17.1, U10.1 (G1), U14.27 (PB1)
L_ENC_A: K1.6 (A), U14.41 (PA8/TIM1_CH1)
L_ENC_B: K1.5 (B), U14.42 (PA9/TIM1_CH2)
L_IN1: U2.4 (IN1), U14.37 (PC6/TIM8_CH1)
L_IN2: U2.5 (IN2), U14.38 (PC7/TIM8_CH2)
Line_IR_F: R21.2, U14.15 (PA1/ADC3_IN1), U18.3 (C)
Line_IR_L1: R20.2, U14.20 (PA4/ADC1_IN4), U17.3 (C)
Line_IR_L2: R10.2, U14.17 (PA3/ADC3_IN3), U16.3 (C)
Line_IR_R1: R24.2, U14.11 (PC3/ADC3_IN13), U19.3 (C)
Line_IR_R2: R25.2, U14.10 (PC2/ADC3_IN12), U20.3 (C)
NSRST: C44.2, P1.4, PL1.3 (NSRST), R26.2, U14.7 (NSRST)
unnamed: ADXR1.1C (SUMJ), ADXR1.2C (SUMJ), C36.2, R3.1
unnamed: ADXR1.4A (CP2), ADXR1.4B (CP2), C38.1
unnamed: ADXR1.5A (CP1), ADXR1.5B (CP1), C38.2
unnamed: ADXR1.6A (CP4), ADXR1.7B (CP4), C37.1
unnamed: ADXR1.6C (CP3), ADXR1.7C (CP3), C37.2
unnamed: ADXR1.6D (CP5), ADXR1.7D (CP5), C39.1
unnamed: C4.1, U3.15 (CP1)
unnamed: C4.2, U3.1 (CP2)
unnamed: C5.1, U2.15 (CP1)
unnamed: C5.2, U2.1 (CP2)
unnamed: C6.1, U3.16 (CP4)
unnamed: C6.2, U3.14 (CP3)
unnamed: C7.1, U2.16 (CP4)
unnamed: C7.2, U2.14 (CP3)
unnamed: C10.2, R9.1, SCH1.2 (K), U4.6 (Vin), U5.1 (S1), U5.4 (S2)
unnamed: C11.1, U4.3 (TMR)
unnamed: C12.2, U2.13 (VCP)
unnamed: C13.2, U3.13 (VCP)
unnamed: C27.2, U14.31 (V-CAP_1)
unnamed: C29.2, U14.47 (V-CAP_2)
unnamed: C40.1, U14.5 (PH0/OSC_IN), X1.3
unnamed: C41.1, U14.6 (PH1/OSC_OUT), X1.1
unnamed: D1.1 (A), R38.1, SP1.2
unnamed: D11.1 (A), R1.1
unnamed: D11.2 (K), U1.7 (STAT)
unnamed: D12.1 (A), R19.1
unnamed: D12.2 (K), Q2.D
unnamed: IR1.2 (K), R34.1
unnamed: IR2.1 (A), IR3.2 (K)
unnamed: IR2.2 (K), R35.2
unnamed: IR4.2 (K), R39.1
unnamed: K1.1 (M-), U2.12 (OUTA)
unnamed: K1.2 (M+), U2.10 (OUTB)
unnamed: K2.1 (M-), U3.12 (OUTA)
unnamed: K2.2 (M+), U3.10 (OUTB)
unnamed: K3.1, R52.2
unnamed: K3.2, R51.2
unnamed: Q1.D, U16.2 (K), U17.2 (K), U20.2 (K)
unnamed: R5.2, U6.5 (G2), U6.6 (D1)
unnamed: R11.2, U1.10 (PROG)
unnamed: R9.2, R12.1, U5.2 (G1)
unnamed: R12.2, U4.7 (EN)
unnamed: R15.2, U6.3 (D2)
unnamed: R27.1, U2.11 (SENSE)
unnamed: R28.1, U3.11 (SENSE)
unnamed: R34.2, U10.6 (D1)
unnamed: R35.1, U10.4 (D2)
unnamed: R38.2, U11.4 (D2)
unnamed: R39.2, U11.6 (D1)
unnamed: R50.2, U14.60 (BOOT0)
unnamed: R58.1, U16.1 (A)
unnamed: R64.1, U19.1 (A)
unnamed: R67.1, U20.1 (A)
unnamed: U17.1 (A), U18.2 (K)
unnamed: U18.1 (A), U19.2 (K)
ON/OFF: PL1.2 (ON/OFF), U4.5 (PB)
PA13/JTMS-SWDAT: P1.3, U14.46 (PA13/JTMS-SWDIO)
PA14/JTCK-SWCLK: P1.5, U14.49 (PA14/JTCK-SWCLK)
PIEZZO: R22.1, U11.3 (G2), U14.62 (PB9/TIM11_CH1)
POWER_KILL: R14.1, U4.2 (~KILL), U14.61 (PB8)
PW_LED: Q2.G, R29.1, U14.50 (PA15)
RDiag_RX: IR3.3 (E), R48.1, U14.8 (PC0/ADC2_IN10)
RFront_RX: IR4.3 (E), R49.1, U14.9 (PC1/ADC2_IN11)
RFront_TX: R23.1, U11.1 (G1), U14.29 (PB10)
R_ENC_A: K2.5 (B), U14.56 (PB4/TIM3_CH1)
R_ENC_B: K2.6 (A), U14.57 (PB5/TIM3_CH2)
R_IN1: U3.4 (IN1), U14.39 (PC8/TIM8_CH3)
R_IN2: U3.5 (IN2), U14.40 (PC9/TIM8_CH4)
SLEEP: R2.2, U2.3 (~SLEEP), U3.3 (~SLEEP), U14.44 (PA11)
TEST_BAT: R15.1, R16.2, U14.25 (PC5/ADC1_IN15)
USART_RX: R51.1, U14.52 (PC11/USART3_RX)
USART_TX: R52.1, U14.51 (PC10/USART3_TX)
WKUP: R13.1, U4.8 (~INT), U14.14 (PA0/SYS_WKUP)
WP_EEPROM: R33.1, U12.5 (WP), U14.55 (PB3/JTDO-SWO)

Notes on the sheet:
Power Managment
Tantale - 1210
8Z-16
Tantale - 1206
IR Line Sensors
USART Connector
Magnet Jtag & Power Connector
Motors Drivers
IR Sensors Mosfets
IR Sensors
Gyro
0102 - 0805
Rouge
Connecteur Platine
QRE1113
Battery voltage measurement
Reset RC
Power Led
EEprom
