pacabot/zhonx3-kicad/Zhonx_III_mere_V3/Zhonx_III_test.sch

## KiCad design Zhonx_III_mere_V3/Zhonx_III_test.sch (2015-01-23)

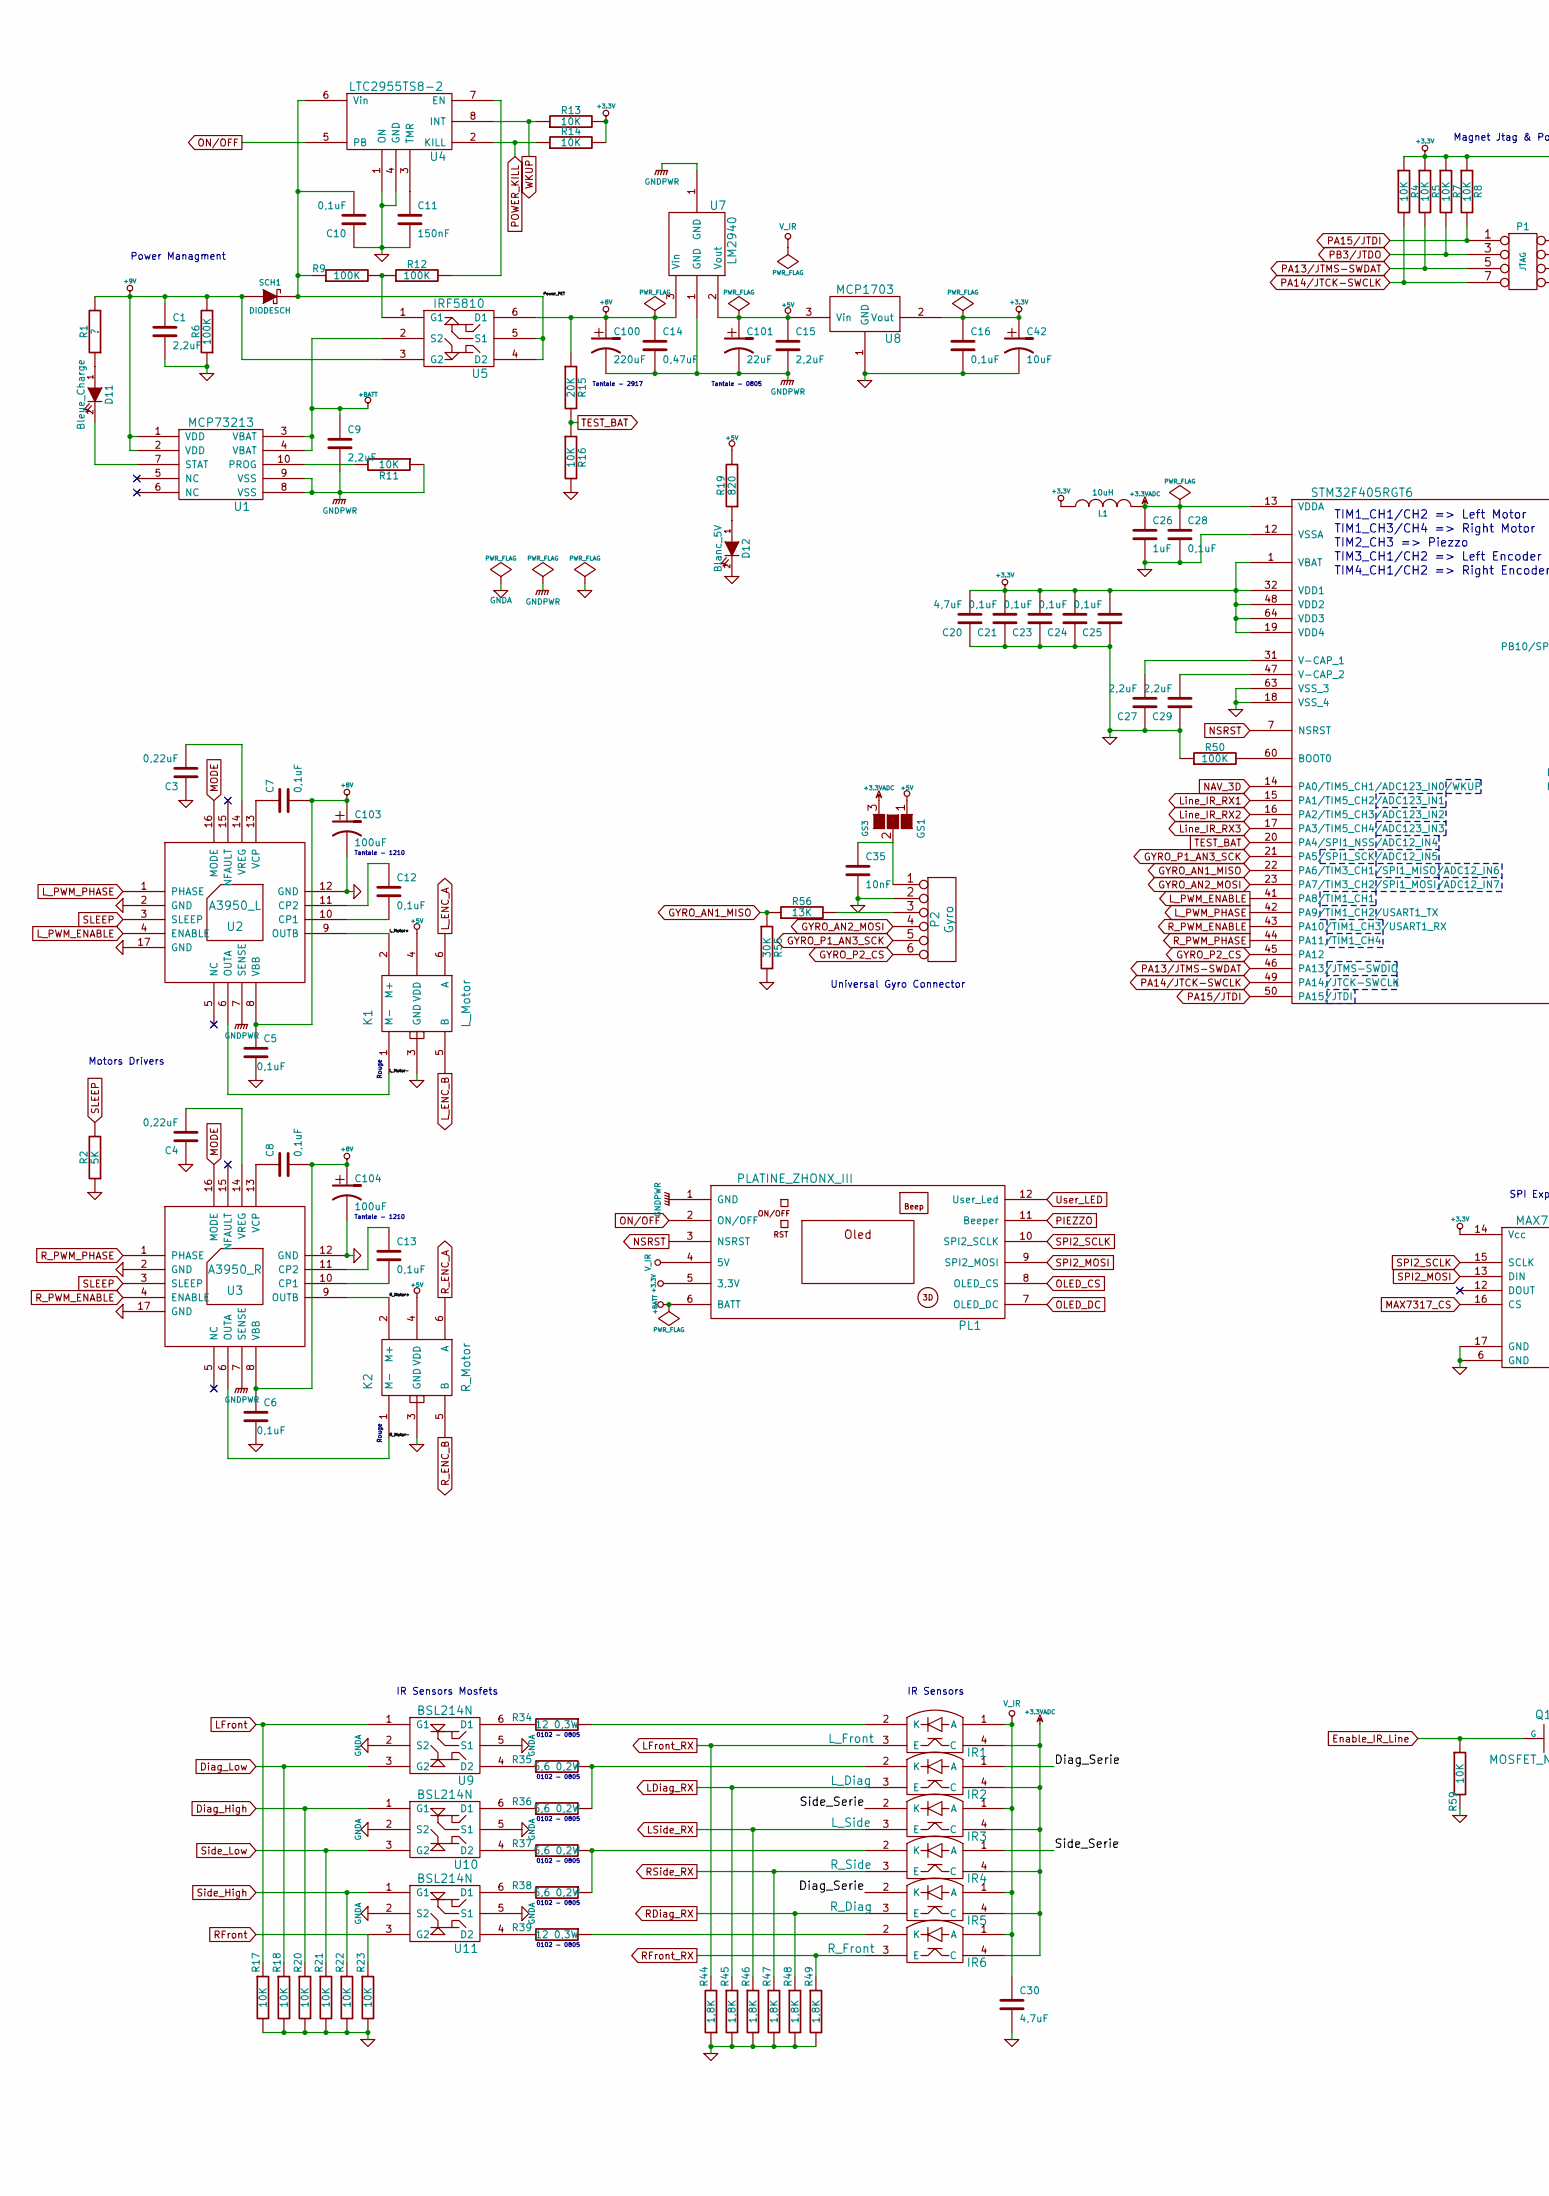
[picture p31: schematic Zhonx_III_test.sch, part in row 1, column 1]

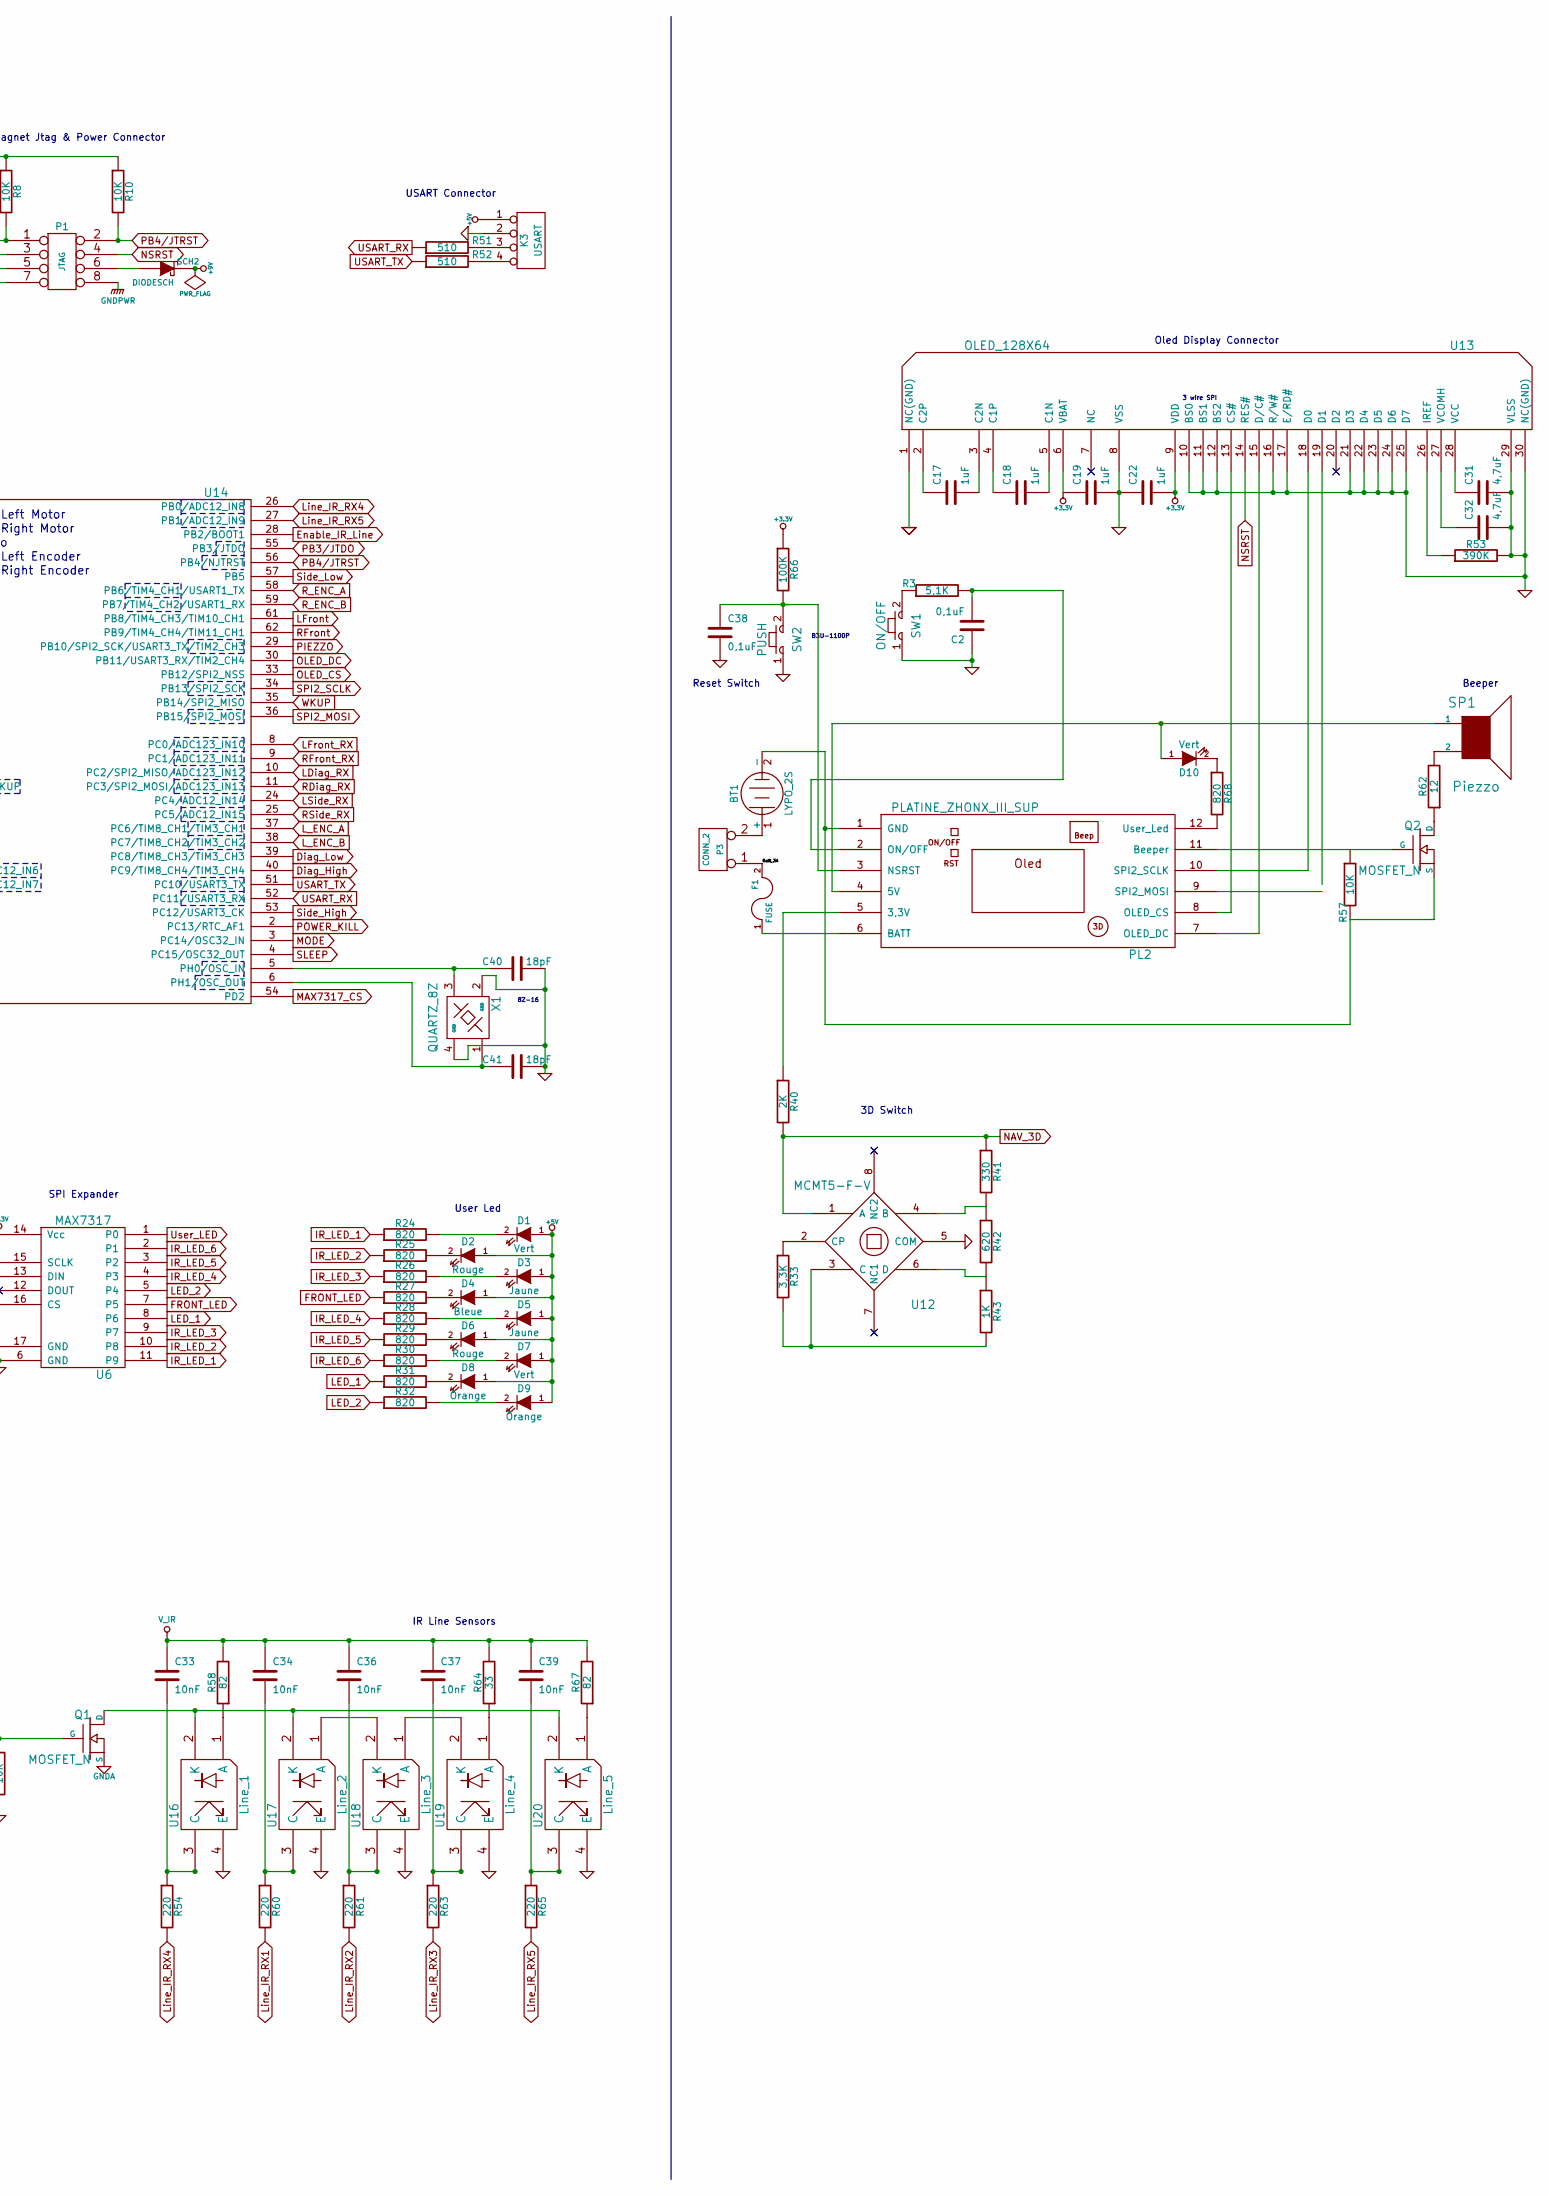
[picture p32: schematic Zhonx_III_test.sch, part in row 1, column 2]

Parts:
BT1: LYPO_2S
C1, C9, C15, C27, C29: 2,2uF
C2, C5, C6, C7, C8, C10, C12, C13, C16, C21, C23, C24, C25, C28, C38: 0,1uF
C3, C4: 0,22uF
C11: 150nF
C14: 0,47uF
C17, C18, C19, C22, C26: 1uF
C20, C30, C31, C32: 4,7uF
C33, C34, C35, C36, C37, C39: 10nF
C40, C41: 18pF
C42: 10uF
C100: 220uF
C101: 22uF
C103, C104: 100uF
D1, D7, D10: Vert
D2, D6: Rouge
D3, D5: Jaune
D4: Bleue
D8, D9: Orange
D11: Bleue_Charge
D12: Blanc_5V
F1: FUSE
GS1: GS3
IR1: L_Front
IR2: L_Diag
IR3: L_Side
IR4: R_Side
IR5: R_Diag
IR6: R_Front
K1: L_Motor
K2: R_Motor
K3: USART
L1: 10uH
P1: JTAG
P2: Gyro
P3: CONN_2
PL1: PLATINE_ZHONX_III
PL2: PLATINE_ZHONX_III_SUP
Q1, Q2: MOSFET_N
R1: ?
R2: 5K
R3: 5,1K
R4, R5, R7, R8, R10, R11, R13, R14, R16, R17, R18, R20, R21, R22, R23, R57, R59: 10K
R6, R9, R12, R50, R66: 100K
R15: 20K
R19, R24, R25, R26, R27, R28, R29, R30, R31, R32, R68: 820
R33: 3,3K
R34, R39: 12 0,3W
R35, R36, R37, R38: 5,6 0,2W
R40: 2K
R41: 330
R42: 620
R43: 1K
R44, R45, R46, R47, R48, R49: 1,8K
R51, R52: 510
R53: 390K
R54, R60, R61, R63, R65: 220
R55: 30K
R56: 13K
R58, R67: 82
R62: 12
R64: 33
SCH1, SCH2: DIODESCH
SP1: Piezzo
SW1: ON/OFF
SW2: PUSH
U1: MCP73213
U2: A3950_L
U3: A3950_R
U4: LTC2955TS8-2
U5: IRF5810
U6: MAX7317
U7: LM2940
U8: MCP1703
U9, U10, U11: BSL214N
U12: MCMT5-F-V
U13: OLED_128X64
U14: STM32F405RGT6
U16: Line_1
U17: Line_2
U18: Line_3
U19: Line_4
U20: Line_5
X1: QUARTZ_8Z

Connections:
+3.3V: C16.1, C19.1, C20.2, C21.2, C22.2, C23.2, C24.2, C25.2, C42.1, L1.1, PL1.5 (3,3V), R4.1, R5.1, R7.1, R8.1, R10.1, R13.2, R14.2, R66.1, U6.14 (Vcc), U8.2 (Vout), U13.6 (VBAT), U13.9 (VDD), U14.1 (VBAT), U14.19 (VDD4), U14.32 (VDD1), U14.48 (VDD2), U14.64 (VDD3)
+3.3VADC: C26.1, C28.1, GS1.3 (G3), IR1.4 (C), IR2.4 (C), IR3.4 (C), IR4.4 (C), IR5.4 (C), IR6.4 (C), L1.2, U14.13 (VDDA)
+5V: C15.1, C101.1, D1.1 (A), D2.1 (A), D3.1 (A), D4.1 (A), D5.1 (A), D6.1 (A), D7.1 (A), D8.1 (A), D9.1 (A), GS1.1 (G1), K1.4 (VDD), K2.4 (VDD), K3.1, R19.2, U7.2 (Vout), U8.3 (Vin)
+8V: C5.1, C6.1, C7.2, C8.2, C14.1, C100.1, C103.1, C104.1, R15.1, U2.8 (VBB), U3.8 (VBB), U5.6 (D1), U7.3 (Vin)
+9V: C1.1, R1.2, R6.2, SCH1.1 (A), SCH2.2 (K), U1.1 (VDD), U1.2 (VDD), U5.3 (G2)
+BATT: C9.1, PL1.6 (BATT), U1.3 (VBAT), U1.4 (VBAT), U5.2 (S2)
Batt_3A: F1.2, P3.1
Diag_High: R20.1, U10.1 (G1), U14.40 (PC9/TIM8_CH4/TIM3_CH4)
Diag_Low: R18.1, U9.3 (G2), U14.39 (PC8/TIM8_CH3/TIM3_CH3)
Diag_Serie: IR2.1 (A), IR5.2 (K)
Enable_IR_Line: Q1.G, R59.1, U14.28 (PB2/BOOT1)
FRONT_LED: R27.1, U6.7 (P5)
GND: C1.2, C2.1, C3.1, C4.1, C5.2, C6.2, C10.1, C11.2, C16.2, C19.2, C20.1, C21.1, C22.1, C23.1, C24.1, C25.1, C26.2, C27.1, C28.2, C29.1, C30.2, C31.2, C32.2, C35.2, C38.2, C40.2, C41.2, C42.2, C103.2, C104.2, D12.2 (K), K1.3 (GND), K2.3 (GND), K3.2, P2.2, R2.1, R6.1, R16.2, R17.2, R18.2, R20.2, R21.2, R22.2, R23.2, R44.1, R45.2, R46.2, R47.2, R48.2, R49.2, R50.1, R53.2, R55.2, R59.2, SW1.1, SW2.1, U2.2 (GND), U2.12 (GND), U2.17 (GND), U3.2 (GND), U3.12 (GND), U3.17 (GND), U4.1 (ON), U4.4 (GND), U6.6 (GND), U6.17 (GND), U8.1 (GND), U12.5 (COM), U13.1 (NC(GND)), U13.8 (VSS), U13.10 (BS0), U13.11 (BS1), U13.12 (BS2), U13.16 (R/W#), U13.17 (E/RD#), U13.21 (D3), U13.22 (D4), U13.23 (D5), U13.24 (D6), U13.25 (D7), U13.29 (VLSS), U13.30 (NC(GND)), U14.12 (VSSA), U14.18 (VSS_4), U14.63 (VSS_3), U16.4 (E), U17.4 (E), U18.4 (E), U19.4 (E), U20.4 (E), X1.2 (GND), X1.4 (GND)
GNDA: Q1.S, U9.2 (S2), U9.5 (S1), U10.2 (S2), U10.5 (S1), U11.2 (S2), U11.5 (S1)
GNDPWR: C9.2, C14.2, C15.2, C100.2, C101.2, P1.8, PL1.1 (GND), R11.1, U1.8 (VSS), U1.9 (VSS), U2.7 (SENSE), U3.7 (SENSE), U7.1 (GND)
GYRO_AN1_MISO: R55.1, R56.1, U14.22 (PA6/TIM3_CH1/SPI1_MISO/ADC12_IN6)
GYRO_AN2_MOSI: P2.4, U14.23 (PA7/TIM3_CH2/SPI1_MOSI/ADC12_IN7)
GYRO_P1_AN3_SCK: P2.5, U14.21 (PA5/SPI1_SCK/ADC12_IN5)
GYRO_P2_CS: P2.6, U14.45 (PA12)
IR_LED_1: R24.1, U6.11 (P9)
IR_LED_2: R25.1, U6.10 (P8)
IR_LED_3: R26.1, U6.9 (P7)
IR_LED_4: R28.1, U6.4 (P3)
IR_LED_5: R29.1, U6.3 (P2)
IR_LED_6: R30.1, U6.2 (P1)
LDiag_RX: IR2.3 (E), R45.1, U14.10 (PC2/SPI2_MISO/ADC123_IN12)
LED_1: R31.1, U6.8 (P6)
LED_2: R32.1, U6.5 (P4)
LFront: R17.1, U9.1 (G1), U14.61 (PB8/TIM4_CH3/TIM10_CH1)
LFront_RX: IR1.3 (E), R44.2, U14.8 (PC0/ADC123_IN10)
LSide_RX: IR3.3 (E), R46.1, U14.24 (PC4/ADC12_IN14)
L_ENC_A: K1.6 (A), U14.37 (PC6/TIM8_CH1/TIM3_CH1)
L_ENC_B: K1.5 (B), U14.38 (PC7/TIM8_CH2/TIM3_CH2)
L_Motor+: K1.2 (M+), U2.9 (OUTB)
L_Motor-: K1.1 (M-), U2.6 (OUTA)
L_PWM_ENABLE: U2.4 (ENABLE), U14.41 (PA8/TIM1_CH1)
L_PWM_PHASE: U2.1 (PHASE), U14.42 (PA9/TIM1_CH2/USART1_TX)
Line_IR_RX1: R60.2, U14.15 (PA1/TIM5_CH2/ADC123_IN1)
Line_IR_RX2: R61.2, U14.16 (PA2/TIM5_CH3/ADC123_IN2)
Line_IR_RX3: R63.2, U14.17 (PA3/TIM5_CH4/ADC123_IN3)
Line_IR_RX4: R54.2, U14.26 (PB0/ADC12_IN8)
Line_IR_RX5: R65.2, U14.27 (PB1/ADC12_IN9)
MAX7317_CS: U6.16 (CS), U14.54 (PD2)
MODE: U2.16 (MODE), U3.16 (MODE), U14.3 (PC14/OSC32_IN)
NAV_3D: R40.2, R41.1, U12.1 (A), U14.14 (PA0/TIM5_CH1/ADC123_IN0/WKUP)
NSRST: P1.4, PL1.3 (NSRST), U13.14 (RES#), U14.7 (NSRST)
unnamed: BT1.1 (+), P3.2 (PM)
unnamed: BT1.2 (-), PL2.1 (GND), Q2.S, R57.2
unnamed: C2.2, PL2.2 (ON/OFF), R3.2
unnamed: C3.2, U2.14 (VREG)
unnamed: C4.2, U3.14 (VREG)
unnamed: C7.1, U2.13 (VCP)
unnamed: C8.1, U3.13 (VCP)
unnamed: C11.1, U4.3 (TMR)
unnamed: C12.1, U2.11 (CP2)
unnamed: C12.2, U2.10 (CP1)
unnamed: C13.1, U3.11 (CP2)
unnamed: C13.2, U3.10 (CP1)
unnamed: C17.1, U13.2 (C2P)
unnamed: C17.2, U13.3 (C2N)
unnamed: C18.1, U13.4 (C1P)
unnamed: C18.2, U13.5 (C1N)
unnamed: C27.2, U14.31 (V-CAP_1)
unnamed: C29.2, U14.47 (V-CAP_2)
unnamed: C31.1, U13.28 (VCC)
unnamed: C32.1, U13.27 (VCOMH)
unnamed: C33.2, R54.1, U16.3 (C)
unnamed: C34.2, R60.1, U17.3 (C)
unnamed: C35.1, GS1.2 (G2), P2.1
unnamed: C36.2, R61.1, U18.3 (C)
unnamed: C37.2, R63.1, U19.3 (C)
unnamed: C38.1, PL2.3 (NSRST), R66.2, SW2.2
unnamed: C39.2, R65.1, U20.3 (C)
unnamed: C40.1, U14.5 (PH0/OSC_IN), X1.3
unnamed: C41.1, U14.6 (PH1/OSC_OUT), X1.1
unnamed: D1.2 (K), R24.2
unnamed: D2.2 (K), R25.2
unnamed: D3.2 (K), R26.2
unnamed: D4.2 (K), R27.2
unnamed: D5.2 (K), R28.2
unnamed: D6.2 (K), R29.2
unnamed: D7.2 (K), R30.2
unnamed: D8.2 (K), R31.2
unnamed: D9.2 (K), R32.2
unnamed: D10.1 (A), PL2.4 (5V), SP1.1
unnamed: D10.2 (K), R68.1
unnamed: D11.1 (A), R1.1
unnamed: D11.2 (K), U1.7 (STAT)
unnamed: D12.1 (A), R19.1
unnamed: F1.1, PL2.6 (BATT)
unnamed: IR1.2 (K), R34.1
unnamed: IR2.2 (K), R35.2, R36.2
unnamed: IR4.2 (K), R37.2, R38.1
unnamed: IR6.2 (K), R39.1
unnamed: K3.3, R51.2
unnamed: K3.4, R52.2
unnamed: P1.6, SCH2.1 (A)
unnamed: P2.3, R56.2
unnamed: PL2.5 (3,3V), R40.1
unnamed: PL2.7 (OLED_DC), U13.15 (D/C#)
unnamed: PL2.8 (OLED_CS), U13.13 (CS#)
unnamed: PL2.10 (SPI2_SCLK), U13.18 (D0)
unnamed: PL2.11 (Beeper), Q2.G
unnamed: PL2.12 (User_Led), R68.2
unnamed: Q1.D, U16.2 (K), U17.2 (K), U20.2 (K)
unnamed: Q2.D, R62.1
unnamed: R3.1, SW1.2
unnamed: R11.2, U1.10 (PROG)
unnamed: R9.2, R12.1, U5.1 (G1)
unnamed: R12.2, U4.7 (EN)
unnamed: R33.1, U12.2 (CP)
unnamed: R33.2, R43.2, U12.3 (C)
unnamed: R34.2, U9.6 (D1)
unnamed: R35.1, U9.4 (D2)
unnamed: R36.1, U10.6 (D1)
unnamed: R37.1, U10.4 (D2)
unnamed: R38.2, U11.6 (D1)
unnamed: R39.2, U11.4 (D2)
unnamed: R41.2, R42.1, U12.4 (B)
unnamed: R42.2, R43.1, U12.6 (D)
unnamed: R50.2, U14.60 (BOOT0)
unnamed: R53.1, U13.26 (IREF)
unnamed: R58.1, U16.1 (A)
unnamed: R62.2, SP1.2
unnamed: R64.1, U19.1 (A)
unnamed: R67.1, U20.1 (A)
unnamed: U17.1 (A), U18.2 (K)
unnamed: U18.1 (A), U19.2 (K)
OLED_CS: PL1.8 (OLED_CS), U14.33 (PB12/SPI2_NSS)
OLED_DC: PL1.7 (OLED_DC), U14.30 (PB11/USART3_RX/TIM2_CH4)
ON/OFF: PL1.2 (ON/OFF), U4.5 (PB)
PA13/JTMS-SWDAT: P1.5, R5.2, U14.46 (PA13/JTMS-SWDIO)
PA14/JTCK-SWCLK: P1.7, R4.2, U14.49 (PA14/JTCK-SWCLK)
PA15/JTDI: P1.1, R8.2, U14.50 (PA15/JTDI)
PB3/JTDO: P1.3, R7.2, U14.55 (PB3/JTDO)
PB4/JTRST: P1.2, R10.2, U14.56 (PB4/NJTRST)
PIEZZO: PL1.11 (Beeper), U14.29 (PB10/SPI2_SCK/USART3_TX/TIM2_CH3)
POWER_KILL: R14.1, U4.2 (KILL), U14.2 (PC13/RTC_AF1)
Power_FET: C10.2, R9.1, SCH1.2 (K), U4.6 (Vin), U5.4 (D2), U5.5 (S1)
RDiag_RX: IR5.3 (E), R48.1, U14.11 (PC3/SPI2_MOSI/ADC123_IN13)
RFront: R23.1, U11.3 (G2), U14.62 (PB9/TIM4_CH4/TIM11_CH1)
RFront_RX: IR6.3 (E), R49.1, U14.9 (PC1/ADC123_IN11)
RSide_RX: IR4.3 (E), R47.1, U14.25 (PC5/ADC12_IN15)
R_ENC_A: K2.6 (A), U14.58 (PB6/TIM4_CH1/USART1_TX)
R_ENC_B: K2.5 (B), U14.59 (PB7/TIM4_CH2/USART1_RX)
R_Motor+: K2.2 (M+), U3.9 (OUTB)
R_Motor-: K2.1 (M-), U3.6 (OUTA)
R_PWM_ENABLE: U3.4 (ENABLE), U14.43 (PA10/TIM1_CH3/USART1_RX)
R_PWM_PHASE: U3.1 (PHASE), U14.44 (PA11/TIM1_CH4)
SLEEP: R2.2, U2.3 (SLEEP), U3.3 (SLEEP), U14.4 (PC15/OSC32_OUT)
SPI2_MOSI: PL1.9 (SPI2_MOSI), U6.13 (DIN), U14.36 (PB15/SPI2_MOSI)
SPI2_SCLK: PL1.10 (SPI2_SCLK), U6.15 (SCLK), U14.34 (PB13/SPI2_SCK)
Side_High: R22.1, U11.1 (G1), U14.53 (PC12/USART3_CK)
Side_Low: R21.1, U10.3 (G2), U14.57 (PB5)
Side_Serie: IR3.2 (K), IR4.1 (A)
TEST_BAT: R15.2, R16.1, U14.20 (PA4/SPI1_NSS/ADC12_IN4)
USART_RX: R51.1, U14.52 (PC11/USART3_RX)
USART_TX: R52.1, U14.51 (PC10/USART3_TX)
User_LED: PL1.12 (User_Led), U6.1 (P0)
V_IR: C30.1, C33.1, C34.1, C36.1, C37.1, C39.1, IR1.1 (A), IR3.1 (A), IR5.1 (A), IR6.1 (A), PL1.4 (5V), R58.2, R64.2, R67.2
WKUP: R13.1, U4.8 (INT), U14.35 (PB14/SPI2_MISO)

Notes on the sheet:
Power Managment
SPI Expander
Tantale - 2917
8Z-16
Tantale - 0805
IR Line Sensors
USART Connector
Magnet Jtag & Power Connector
Motors Drivers
IR Sensors Mosfets
IR Sensors
User Led
Universal Gyro Connector
TIM1_CH1/CH2 => Left Motor
TIM2_CH3 => Piezzo
TIM3_CH1/CH2 => Left Encoder
TIM4_CH1/CH2 => Right Encoder
TIM1_CH3/CH4 => Right Motor
Tantale - 1210
0102 - 0805
Rouge
3 wire SPI
B3U-1100P
Oled Display Connector
Reset Switch
3D Switch
Beeper
