pacabot/zhonx3-kicad/Zhonx_III_platine/Zhonx_Platine.sch

## KiCad design Zhonx_III_platine/Zhonx_Platine.sch (2015-03-20, an earlier design)


Parts:
BT1: LIPO_2S
C1, C10: 0,1uF
C2: 10uF
C3: 0,1uF
C4, C5, C6, C7: 1uF
C8, C9: 4,7uF
D1, D3, D4: LED
F1: FUSE
PL1: PLATINE_ZHONX_III_SUP
R1, R2, R3, R4, R5: 47K
R6, R10: NC
R7, R8, R9: 820
R11: 390K
R14: 5,1K
R15: 100K
SW3: ON/OFF
SW4: PUSH
U1: MCP1700
U2: PCF8574R
U3: OLED_128X64
U4: MCMT5-F-V

Connections:
3D_A: R3.2, U2.7 (P2), U4.1 (A)
3D_B: R2.2, U2.6 (P1), U4.4 (B)
3D_C: R4.2, U2.8 (P3), U4.3 (C)
3D_D: R1.2, U2.5 (P0), U4.6 (D)
+3.3V: C1.1, C2.1, C6.1, C7.2, R1.1, R2.1, R3.1, R4.1, R5.1, R6.1, R10.1, R15.1, U1.2 (Vout), U2.1 (Vcc), U3.6 (VBAT), U3.9 (VDD), U3.11 (BS1)
+5V: PL1.5 (5V), R7.2, R8.2, R9.2, U1.3 (Vin)
+BATT: F1.2, PL1.4 (BATT)
GND: BT1.2 (-), C1.2, C2.2, C3.1, C6.2, C7.1, C8.2, C9.2, C10.1, PL1.1 (GND), PL1.8 (GND), R11.2, SW3.1, SW4.1, U1.1 (GND), U2.2 (A0), U2.3 (A1), U2.4 (A2), U2.9 (GND), U2.17 (Pad), U3.1 (NC(GND)), U3.8 (VSS), U3.10 (BS0), U3.12 (BS2), U3.13 (CS#), U3.15 (D/C#), U3.16 (R/W#), U3.17 (E/RD#), U3.21 (D3), U3.22 (D4), U3.23 (D5), U3.24 (D6), U3.25 (D7), U3.29 (VLSS), U3.30 (NC(GND)), U4.5 (COM)
I2C_CLK: PL1.7 (I2C_CLK), R6.2, U2.15 (SCL), U3.18 (D0)
I2C_SDA: PL1.6 (I2C_SDA), R10.2, U2.16 (SDA), U3.19 (D1), U3.20 (D2)
NSRST: C3.2, PL1.3 (NSRST), R15.2, SW4.2
unnamed: BT1.1 (+), F1.1
unnamed: C4.1, U3.2 (C2P)
unnamed: C4.2, U3.3 (C2N)
unnamed: C5.1, U3.4 (C1P)
unnamed: C5.2, U3.5 (C1N)
unnamed: C8.1, U3.28 (VCC)
unnamed: C9.1, U3.27 (VCOMH)
unnamed: D1.1 (A), R8.1
unnamed: D1.2 (K), U2.11 (P5)
unnamed: D3.1 (A), R7.1
unnamed: D3.2 (K), U2.10 (P4)
unnamed: D4.1 (A), R9.1
unnamed: D4.2 (K), U2.12 (P6)
unnamed: R11.1, U3.26 (IREF)
unnamed: R14.1, SW3.2
OLED_RST: R5.2, U2.13 (P7), U3.14 (RES#)
ON/OFF: C10.2, PL1.2 (ON/OFF), R14.2

Notes on the sheet:
SPI Expander
3D Switch
Oled Display Connector
3 wire SPI
ON/OFF
OLED
Batterie
POWER
