pacabot/zhonx3-kicad/Librairies_Zhonx/main_lib/GitHub_lib/Buildingblocks/78xx_79xxRegler-BuildingBlocks_RevA/78xx-Regler-BuildingBlock_ModA_RevA/78xx-Regler-BuildingBlock_ModA_RevA-cache.lib

## KiCad design Librairies_Zhonx/main_lib/GitHub_lib/Buildingblocks/78xx_79xxRegler-BuildingBlocks_RevA/78xx-Regler-BuildingBlock_ModA_RevA/78xx-Regler-BuildingBlock_ModA_RevA-cache.lib (2017-01-27)

Schematic: 78xx-Regler-BuildingBlock_ModA_RevA-cache.lib

Parts:
C1, C4: CAPACITOR_POLARISED_REVE_DATE15JUN2010
C2, C3: CAPACITOR_REVE_DATE15JUN2010
HS1: HEATSINK_REVE_DATE15JUN2010
IC1: LM78XXTYPE

Notes on the sheet:
78xx Type Regulator. Mod.A, Rev.A 13Apr2011
Author: Bernd Wiebus, Uedem / Germany, 19 April 2011
