pacabot/zhonx3-kicad/Librairies_Zhonx/main_lib/GitHub_lib/Buildingblocks/78xx_79xxRegler-BuildingBlocks_RevA/79xx-Regler-BuildingBlock_ModA_RevA/79xx-Regler-BuildingBlock_ModA_RevA.sch

## KiCad design Librairies_Zhonx/main_lib/GitHub_lib/Buildingblocks/78xx_79xxRegler-BuildingBlocks_RevA/79xx-Regler-BuildingBlock_ModA_RevA/79xx-Regler-BuildingBlock_ModA_RevA.sch (2017-01-27)

Schematic: 79xx-Regler-BuildingBlock_ModA_RevA.sch

Parts:
C1, C4: CAPACITOR_POLARISED_REVE_DATE15JUN2010
C2, C3: CAPACITOR_REVE_DATE15JUN2010
HS1: HEATSINK_REVE_DATE15JUN2010

Notes on the sheet:
79xx Type Regulator. Mod.A, Rev.A 19Apr2011
Author: Bernd Wiebus, Uedem / Germany, 19th. April 2011
