pacabot/zhonx3-kicad/Librairies_Zhonx/main_lib/GitHub_lib/Buildingblocks/317Regler-BuildingBlocks_RevC/317Regulator-BuildingBlock-ModA_RevC/317Regulator-BuildingBlock-ModA_RevC_19Apr2011.sch

## KiCad design Librairies_Zhonx/main_lib/GitHub_lib/Buildingblocks/317Regler-BuildingBlocks_RevC/317Regulator-BuildingBlock-ModA_RevC/317Regulator-BuildingBlock-ModA_RevC_19Apr2011.sch (2017-01-27)

Schematic: 317Regulator-BuildingBlock-ModA_RevC_19Apr2011.sch

Parts:
C1, C5: CAPACITOR_POLARISED_REVE_DATE15JUN2010
C2, C3, C4: CAPACITOR_REVE_DATE15JUN2010
D1, D2: DIODE-STANDARD_REVE_DATE15JUN2010
HS1: HEATSINK_REVE_DATE15JUN2010
IC1: LM317-TO220_REVC_DATE04JUL2010
R1, R2: RESISTOR_REVE_DATE15JUN2010

Notes on the sheet:
Author: Bernd Wiebus, Uedem /Germany, 19th April 2011
317 Type Regulator Building Block Mod.A Rev.C 19Apr2011
