pacabot/zhonx3-kicad/Librairies_Zhonx/main_lib/GitHub_lib/Buildingblocks/317Regler-BuildingBlocks_RevC/317Regulator-BuildingBlock-ModG_RevC/317Regler-BuildingBlock-ModG_RevC_19Apr2011.sch

## KiCad design Librairies_Zhonx/main_lib/GitHub_lib/Buildingblocks/317Regler-BuildingBlocks_RevC/317Regulator-BuildingBlock-ModG_RevC/317Regler-BuildingBlock-ModG_RevC_19Apr2011.sch (2017-01-27)

Schematic: 317Regler-BuildingBlock-ModG_RevC_19Apr2011.sch

Parts:
C1, C5: CAPACITOR_POLARISED_REVE_DATE15JUN2010
C2, C3, C4: CAPACITOR_REVE_DATE15JUN2010
D1, D2: DIODE-STANDARD_REVE_DATE15JUN2010
HS1: HEATSINK_REVE_DATE15JUN2010
IC1: LM317-TO220_REVC_DATE04JUL2010
R1: RESISTOR_VARIABLE_POTENTIOMETER_REVE_DATE15JUN2010
R2, R3, R4, R5, R6: RESISTOR_REVE_DATE15JUN2010

Notes on the sheet:
317 Type Regulator Building Block Mod.G Rev.C 19Apr2011
Author: Bernd Wiebus, Uedem / Germany, 19th. April 2011
