pacabot/zhonx3-kicad/Librairies_Zhonx/main_lib/GitHub_lib/Buildingblocks/555-BuildingBlocks_RevB/555-Oscillator-Adjustable-BuildingBlock_RevB/555-Oscillator-Adjustable-BuildingBlock_RevB_19Apr2011.sch

## KiCad design Librairies_Zhonx/main_lib/GitHub_lib/Buildingblocks/555-BuildingBlocks_RevB/555-Oscillator-Adjustable-BuildingBlock_RevB/555-Oscillator-Adjustable-BuildingBlock_RevB_19Apr2011.sch (2017-01-27)

Schematic: 555-Oscillator-Adjustable-BuildingBlock_RevB_19Apr2011.sch

Parts:
C1, C2, C3, C5, C6: CAPACITOR_REVE_DATE15JUN2010
C4: CAPACITOR_POLARISED_REVE_DATE15JUN2010
IC1: NE555
R1, R3: RESISTOR_REVE_DATE15JUN2010

Notes on the sheet:
555 Oscillator Adjustable Rev.B 19Apr2011
Author: Bernd Wiebus, Uedem / Germany, 19th. April 2011
