pacabot/zhonx3-kicad/Librairies_Zhonx/main_lib/GitHub_lib/Buildingblocks/555-BuildingBlocks_RevB/555-TwoPointRegulator-BuildingBlock_RevB/555-TwoPointRegulator-BuildingBlock_RevB_19Apr2011.sch

## KiCad design Librairies_Zhonx/main_lib/GitHub_lib/Buildingblocks/555-BuildingBlocks_RevB/555-TwoPointRegulator-BuildingBlock_RevB/555-TwoPointRegulator-BuildingBlock_RevB_19Apr2011.sch (2017-01-27)

Schematic: 555-TwoPointRegulator-BuildingBlock_RevB_19Apr2011.sch

Parts:
C1, C2, C3, C5, C6, C7: CAPACITOR_REVE_DATE15JUN2010
C4: CAPACITOR_POLARISED_REVE_DATE15JUN2010
IC1: NE555
R1, R2, R3, R4, R5, R6, R7, R8, R9: RESISTOR_REVE_DATE15JUN2010

Notes on the sheet:
Two Point Regulator with 555 Rev.B 19Apr2011
Author: Bernd Wiebus, Uedem / Germany 19th. April 2011
