pacabot/zhonx3-kicad/(commit log)

2015-01-23 ajout carte BT
    [ContourPCBrepris.dxf, ContourPCBreprisV2.dxf, Zhonx3_carteBT-Edge_CutsV0.dxf, Zhonx3_carteBT.dsn, Zhonx3_carteBT.kicad_pcb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]
2015-02-06 bluetooth passage en 4 couches
    [Zhonx3_carteBT.kicad_pcb, Zhonx_III.sch]
2015-02-06 Organisation des librairies
    [Zhonx_Platine.sch]
2015-03-05 mise a jour schéma carte mère (mesure courant, 4 résistances encodeurs)
    [Zhonx_III.sch]
2015-03-05 Nouvelle librairie (.pretty)
    [Zhonx3_carteBT.kicad_pcb, Zhonx_III.sch, Zhonx_Platine.kicad_pcb]
2015-03-05 Suppréssion Kicad_Lib
2015-03-05 modification affectations E/S STM32
    [Zhonx_III.sch]
2015-03-09 Create Zhonx mere V2
    [Zhonx_III.sch, Zhonx_III_Base.kicad_pcb]
2015-03-09 Update Base V2
    [Zhonx_III_Base.kicad_pcb]
2015-03-20 Add ZHONX_III V2
    [Zhonx_III-Edge_Cuts.dxf, Zhonx_III.kicad_pcb, Zhonx_III.sch, Zhonx_III_Base.kicad_pcb, Zhonx_III_Base.sch, Zhonx_Platine.sch]
2015-05-01 routage pcb (debut ...)
    [Zhonx_III.kicad_pcb]
2015-05-01 Update Base_V2 (CamBam DXF)
    [Zhonx_III.kicad_pcb, Zhonx_III.sch, Zhonx_III_Base.kicad_pcb]
2015-05-01 Add CamBam DXF for Base_V2
    [Zhonx_III_Base-Edge_Cuts.dxf, Zhonx_III_Base-Edge_Cuts_decompose.dxf, Zhonx_III_Base.csv, Zhonx_III_Base.kicad_pcb]
2016-12-10 Update schematic libs
    [Zhonx_III.sch]
2016-12-10 add Classeur.xlsx
    [Classeur.xlsx]
2016-12-10 repair mod librairies
    [Zhonx_III.kicad_pcb, Zhonx_III.sch]
2017-01-27 add main_lib
    [317Regler-BuildingBlock-ModE_RevC_19Apr2011.sch, 317Regler-BuildingBlock-ModF_RevC_19Apr2011.sch, 317Regler-BuildingBlock-ModG_RevC_19Apr2011.sch, 317Regler-BuildingBlock-ModH_RevC_19Apr2011.sch, 317Regulator-BuildingBlock-ModA_RevC_19Apr2011.sch, 317Regulator-BuildingBlock-ModB_RevC_19Apr2011.sch, 317Regulator-BuildingBlock-ModC_RevC_19Apr2011.sch, 317Regulator-BuildingBlock-ModD_RevC_19Apr2011.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]
2017-01-27 rename libs
    [Zhonx_III.sch]
2017-01-27 update lib settigns
    [Zhonx_III.sch]
2017-01-27 new V3 version
    [Zhonx_III-B_Mask.dxf, Zhonx_III-Edge_Cuts.dxf, Zhonx_III-F_Mask.dxf, Zhonx_III.brd, Zhonx_III.csv, Zhonx_III.dsn, Zhonx_III.kicad_pcb, Zhonx_III.sch]
